rayan4444/EasyCheck/EasyCheck_rev2/Easycheck_rev2_motherboard.brd

## EAGLE design EasyCheck_rev2/Easycheck_rev2_motherboard.brd (2019-07-09)

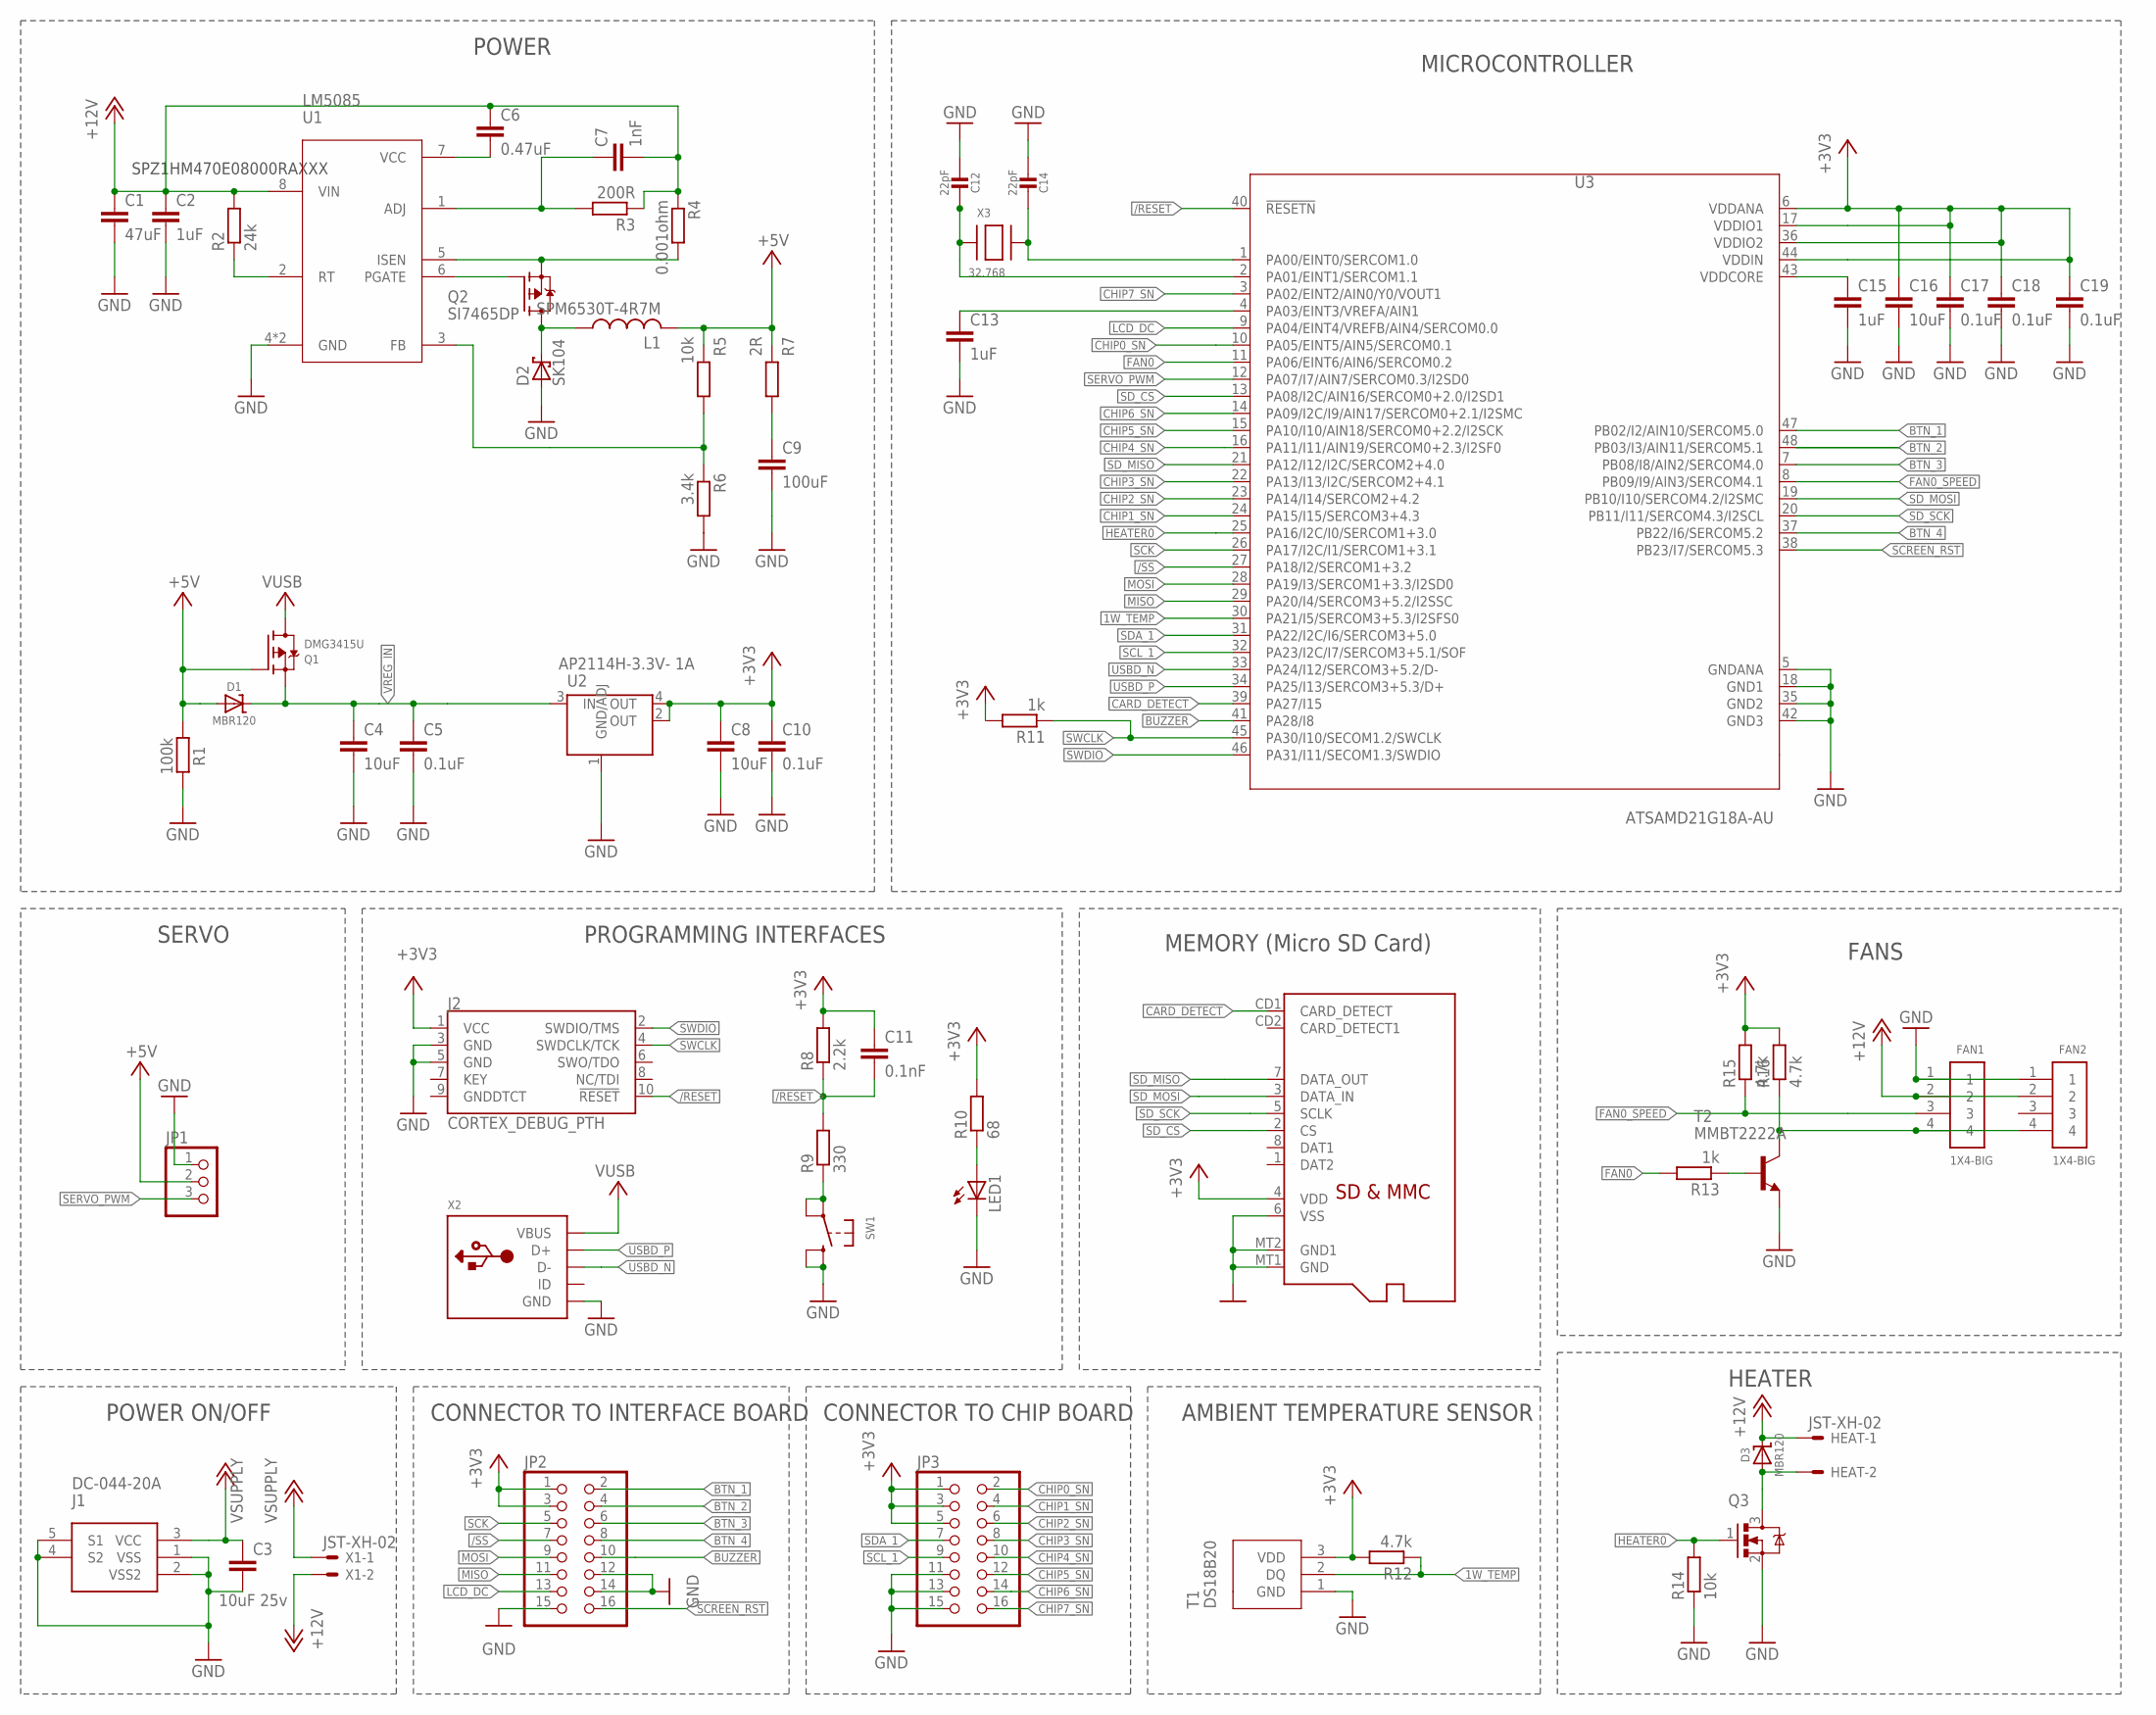
[picture p1: schematic Easycheck_rev2_motherboard.sch]

Parts:
C1: 47uF; C1206
C2: 1uF; C1206
C3: 10uF 25v; C1206
C4, C8, C16: 10uF; C0603
C5, C10, C17, C18, C19: 0.1uF; C0603
C6: 0.47uF; C1206
C7: 1nF; C0603
C9: 100uF; C0805
C11: 0.1nF; C0603
C12, C14: 22pF; 0603-NO@1
C13, C15: 1uF; C0603
D1, D3: MBR120; MICROBUILDER_SOD-123
D2: SK104
FAN1, FAN2: 1X4-BIG; 1X04-BIG
HEAT: JST-XH-02; JST-XH-02-PACKAGE-LONG-PAD
J1: DC-044-20A
J2: CORTEX_DEBUG_PTH; 2X5-PTH-1.27MM
JP1: PINHD-1X3; 1X03
JP2, JP3: PINHD-2X8; 2X08
L1: SPM6530T-4R7M
LED1: LEDCHIPLED_0603; CHIPLED_0603
Q1: DMG3415U; SOT23-R
Q2: SI7465DP; SI7465
Q3: DMN6140L; SOT91P240X110-3N
R1: 100k; R0603
R2: 24k; R0603
R3: 200R; R0603
R4: 0.001ohm; R1206
R5, R14: 10k; R0603
R6: 3.4k; R0603
R7: 2R; R0805
R8: 2.2k; R0603
R9: 330; R0603
R10: 68; R0603
R11, R13: 1k; R0603
R12, R15, R16: 4.7k; R0603
SD1: MICROSD
SW1: MICROBUILDER_SWITCH_TACT_SMT_EVQQ2_SMALL; MICROBUILDER_EVQ-Q2_SMALLER
T1: DS18B20; TO92
T2: MMBT2222A; SOT23-BEC
U1: LM5085
U2: AP2114H-3.3V- 1A; GEN_COMP_SOT223
U3: ATSAMD21G18A-AU; QFP50P900X900X120-48N
X1: JST-XH-02; JST-XH-02-PACKAGE-LONG-PAD
X2: MICROBUILDER_USB_MICRO_20329_V2; MICROBUILDER_4UCONN_20329_V2
X3: 32.768; XTAL3215

Connections:
1W_TEMP: R12.1, T1.2 (DQ), U3.30 (PA21/I5/SERCOM3+5.3/I2SFS0)
+3V3: C8.1, C10.1, C11.1, C16.1, C17.1, C18.1, C19.1, J2.1 (VCC), JP2.1, JP2.3, JP3.1, JP3.3, JP3.5, R8.2, R10.2, R11.2, R12.2, R15.2, R16.2, SD1.4 (VDD), T1.3 (VDD), U2.2 (OUT), U2.4 (OUT), U3.6 (VDDANA), U3.17 (VDDIO1), U3.36 (VDDIO2), U3.44 (VDDIN)
+5V: D1.A, JP1.2, L1.2, Q1.1 (G), R1.1, R5.1, R7.1
+12V: C1.1, C2.1, C6.1, C7.2, D3.C, FAN1.2, FAN2.2, HEAT.1, R2.2, R3.1, R4.1, U1.8 (VIN), X1.2
/RESET: C11.2, J2.10 (!RESET), R8.1, R9.2, U3.40 (!RESETN)
/SS: JP2.7, U3.27 (PA18/I2/SERCOM1+3.2)
BTN_1: JP2.2, U3.47 (PB02/I2/AIN10/SERCOM5.0)
BTN_2: JP2.4, U3.48 (PB03/I3/AIN11/SERCOM5.1)
BTN_3: JP2.6, U3.7 (PB08/I8/AIN2/SERCOM4.0)
BTN_4: JP2.8, U3.37 (PB22/I6/SERCOM5.2)
BUZZER: JP2.10, U3.41 (PA28/I8)
CARD_DETECT: SD1.CD1 (CARD_DETECT), U3.39 (PA27/I15)
CHIP0_SN: JP3.2, U3.10 (PA05/EINT5/AIN5/SERCOM0.1)
CHIP1_SN: JP3.4, U3.24 (PA15/I15/SERCOM3+4.3)
CHIP2_SN: JP3.6, U3.23 (PA14/I14/SERCOM2+4.2)
CHIP3_SN: JP3.8, U3.22 (PA13/I13/I2C/SERCOM2+4.1)
CHIP4_SN: JP3.10, U3.16 (PA11/I11/AIN19/SERCOM0+2.3/I2SF0)
CHIP5_SN: JP3.12, U3.15 (PA10/I10/AIN18/SERCOM0+2.2/I2SCK)
CHIP6_SN: JP3.14, U3.14 (PA09/I2C/I9/AIN17/SERCOM0+2.1/I2SMC)
CHIP7_SN: JP3.16, U3.3 (PA02/EINT2/AIN0/Y0/VOUT1)
FAN0: R13.2, U3.11 (PA06/EINT6/AIN6/SERCOM0.2)
FAN0_SPEED: FAN1.3, R15.1, U3.8 (PB09/I9/AIN3/SERCOM4.1)
GND: C1.2, C2.2, C3.2, C4.2, C5.2, C8.2, C9.2, C10.2, C12.2, C13.2, C14.2, C15.2, C16.2, C17.2, C18.2, C19.2, D2.1 (A), FAN1.1, FAN2.1, J1.1 (VSS), J1.2 (VSS2), J1.4 (S2), J1.5 (S1), J2.3 (GND), J2.5 (GND), JP1.1, JP2.12, JP2.14, JP2.15, JP3.11, JP3.13, JP3.15, LED1.C, Q3.2, R1.2, R6.2, R14.1, SD1.6 (VSS), SD1.MT1 (GND), SD1.MT2 (GND1), SW1.B (S), SW1.B' (S1), T1.1 (GND), T2.E, U1.4 (GND), U1.9 (GND), U2.1 (GND/ADJ), U3.5 (GNDANA), U3.18 (GND1), U3.35 (GND2), U3.42 (GND3), X2.BASE@1 (GND), X2.BASE@2 (GND), X2.GND, X2.SPRT@1 (GND), X2.SPRT@2 (GND), X2.SPRT@3 (GND), X2.SPRT@4 (GND)
HEATER0: Q3.1, R14.2, U3.25 (PA16/I2C/I0/SERCOM1+3.0)
LCD_DC: JP2.13, U3.9 (PA04/EINT4/VREFB/AIN4/SERCOM0.0)
MISO: JP2.11, U3.29 (PA20/I4/SERCOM3+5.2/I2SSC)
MOSI: JP2.9, U3.28 (PA19/I3/SERCOM1+3.3/I2SD0)
unnamed: C9.1, R7.2
unnamed: FAN1.4, FAN2.4, R16.1, T2.C
unnamed: R13.1, T2.B
unnamed: D3.A, HEAT.2, Q3.3
unnamed: R9.1, SW1.A, SW1.A' (P1)
unnamed: C12.1, U3.2 (PA01/EINT1/SERCOM1.1), X3.P$1
unnamed: C14.1, U3.1 (PA00/EINT0/SERCOM1.0), X3.P$2
unnamed: C13.1, U3.4 (PA03/EINT3/VREFA/AIN1)
unnamed: C15.1, U3.43 (VDDCORE)
unnamed: LED1.A, R10.1
unnamed: R2.1, U1.2 (RT)
unnamed: Q2.1 (S), Q2.2 (S), Q2.3 (S), R4.2, U1.5 (ISEN)
unnamed: C7.1, R3.2, U1.1 (ADJ)
unnamed: R5.2, R6.1, U1.3 (FB)
unnamed: C6.2, U1.7 (VCC)
unnamed: D2.2 (C), L1.1, Q2.5 (D), Q2.6 (D), Q2.7 (D), Q2.8 (D), Q2.9 (D)
unnamed: Q2.4 (G), U1.6 (PGATE)
SCK: JP2.5, U3.26 (PA17/I2C/I1/SERCOM1+3.1)
SCL_1: JP3.9, U3.32 (PA23/I2C/I7/SERCOM3+5.1/SOF)
SCREEN_RST: JP2.16, U3.38 (PB23/I7/SERCOM5.3)
SDA_1: JP3.7, U3.31 (PA22/I2C/I6/SERCOM3+5.0)
SD_CS: SD1.2 (CS), U3.13 (PA08/I2C/AIN16/SERCOM0+2.0/I2SD1)
SD_MISO: SD1.7 (DATA_OUT), U3.21 (PA12/I12/I2C/SERCOM2+4.0)
SD_MOSI: SD1.3 (DATA_IN), U3.19 (PB10/I10/SERCOM4.2/I2SMC)
SD_SCK: SD1.5 (SCLK), U3.20 (PB11/I11/SERCOM4.3/I2SCL)
SERVO_PWM: JP1.3, U3.12 (PA07/I7/AIN7/SERCOM0.3/I2SD0)
SWCLK: J2.4 (SWDCLK/TCK), R11.1, U3.45 (PA30/I10/SECOM1.2/SWCLK)
SWDIO: J2.2 (SWDIO/TMS), U3.46 (PA31/I11/SECOM1.3/SWDIO)
USBD_N: U3.33 (PA24/I12/SERCOM3+5.2/D-), X2.D-
USBD_P: U3.34 (PA25/I13/SERCOM3+5.3/D+), X2.D+
VREG_IN: C4.1, C5.1, D1.C, Q1.2 (S), U2.3 (IN)
VSUPPLY: C3.1, J1.3 (VCC), X1.1
VUSB: Q1.3 (D), X2.VBUS

Notes on the sheet:
POWER
SPZ1HM470E08000RAXXX
MICROCONTROLLER
MEMORY (Micro SD Card)
PROGRAMMING INTERFACES
AMBIENT TEMPERATURE SENSOR
FANS
HEATER
POWER ON/OFF
CONNECTOR TO INTERFACE BOARD
CONNECTOR TO CHIP BOARD
SERVO

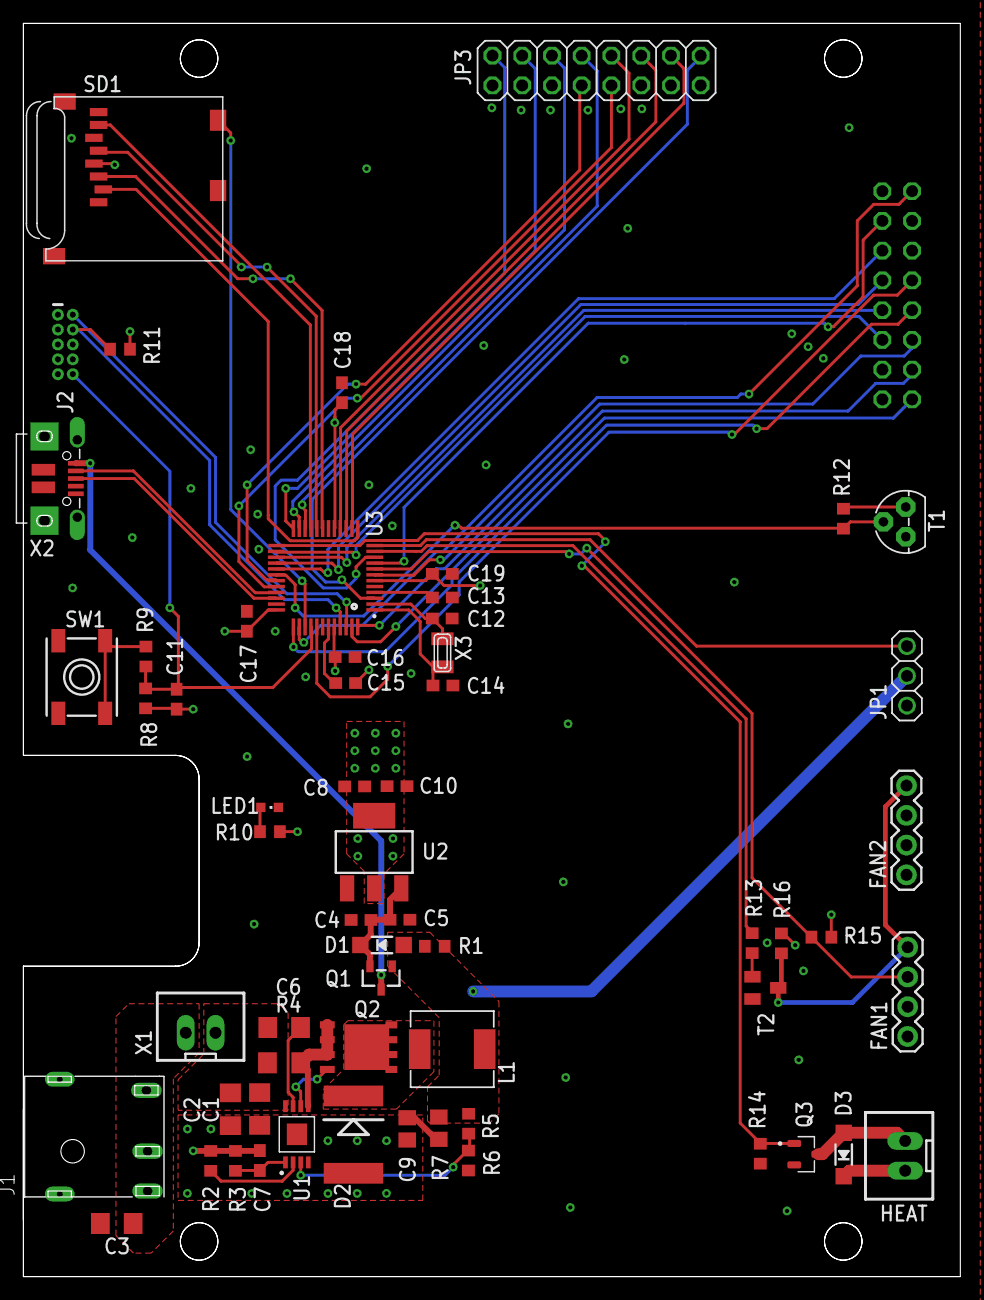
[picture p2: board Easycheck_rev2_motherboard.brd from above]

Board: 4 copper layers, 80.0 x 107.0 mm, 61 parts (1 on the bottom side), 60 nets.
