rayan4444/EasyCheck/EasyCheck_rev2/EasyCheck_rev2_interface.brd

## EAGLE design EasyCheck_rev2/EasyCheck_rev2_interface.brd (2019-07-09)

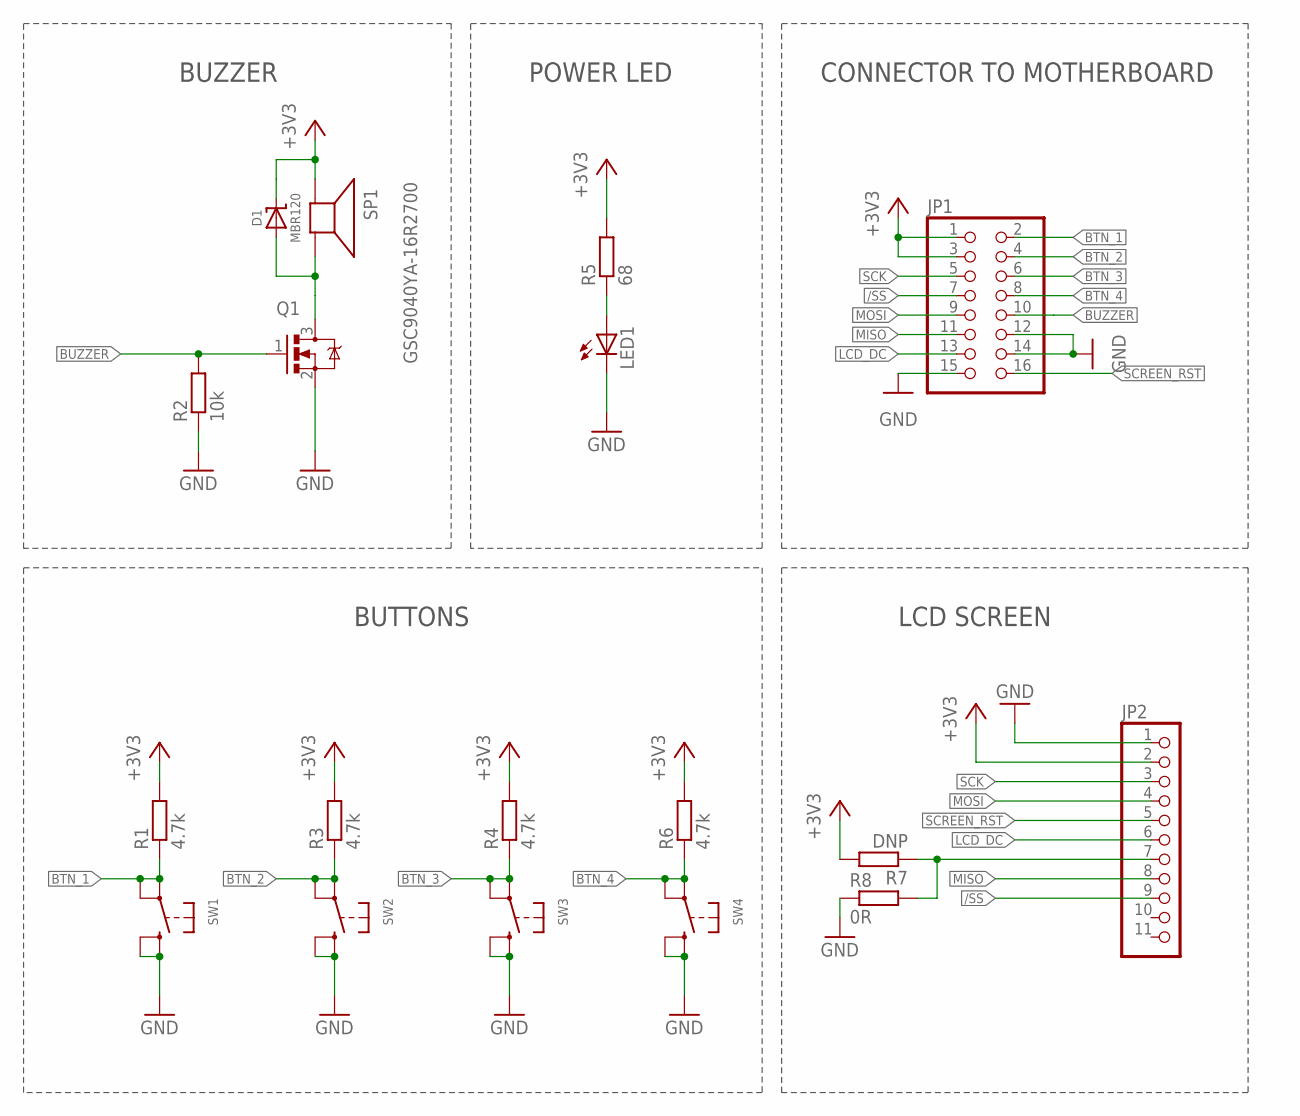
[picture p3: schematic EasyCheck_rev2_interface.sch]

Parts:
D1: MBR120; MICROBUILDER_SOD-123
JP1: PINHD-2X8; 2X08
JP2: PINHD-1X11; 1X11
LED1: LEDCHIPLED_0603; CHIPLED_0603
Q1: DMN6140L; SOT91P240X110-3N
R1, R3, R4, R6: 4.7k; R0603
R2: 10k; R0603
R5: 68; R0603
R7: DNP; R0603
R8: 0R; R0603
SP1: GSC9040YA-16R2700
SW1, SW2, SW3, SW4: MICROBUILDER_SWITCH_TACT_SMT_EVQQ2_SMALL; MICROBUILDER_EVQ-Q2_SMALLER

Connections:
+3V3: D1.C, JP1.1, JP1.3, JP2.2, R1.2, R3.2, R4.2, R5.2, R6.2, R7.2, SP1.P$3 (+)
/SS: JP1.7, JP2.9
BTN_1: JP1.2, R1.1, SW1.A, SW1.A' (P1)
BTN_2: JP1.4, R3.1, SW2.A, SW2.A' (P1)
BTN_3: JP1.6, R4.1, SW3.A, SW3.A' (P1)
BTN_4: JP1.8, R6.1, SW4.A, SW4.A' (P1)
BUZZER: JP1.10, Q1.1, R2.2
GND: JP1.12, JP1.14, JP1.15, JP2.1, LED1.C, Q1.2, R2.1, R8.1, SW1.B (S), SW1.B' (S1), SW2.B (S), SW2.B' (S1), SW3.B (S), SW3.B' (S1), SW4.B (S), SW4.B' (S1)
LCD_DC: JP1.13, JP2.6
MISO: JP1.11, JP2.8
MOSI: JP1.9, JP2.4
unnamed: JP2.7, R7.1, R8.2
unnamed: D1.A, Q1.3, SP1.P$2 (-)
unnamed: LED1.A, R5.1
SCK: JP1.5, JP2.3
SCREEN_RST: JP1.16, JP2.5

Notes on the sheet:
BUZZER
CONNECTOR TO MOTHERBOARD
BUTTONS
LCD SCREEN
POWER LED

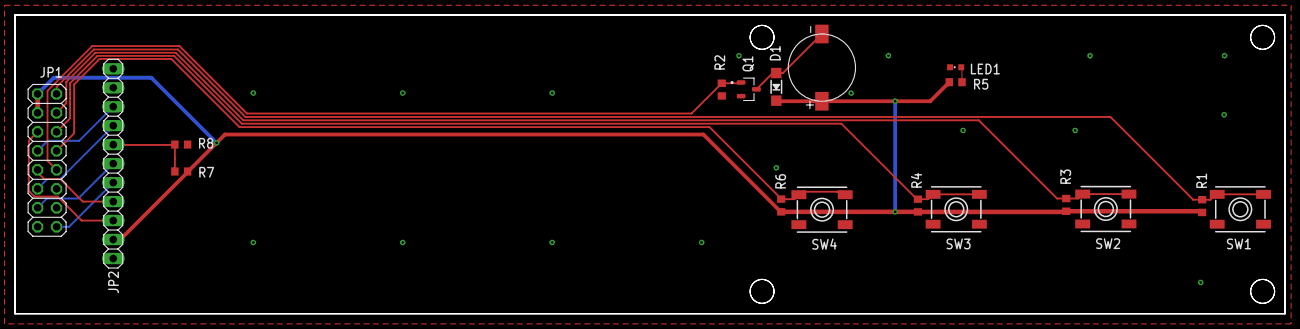
[picture p4: board EasyCheck_rev2_interface.brd from above]

Board: 2 copper layers, 170.0 x 40.0 mm, 18 parts (0 on the bottom side), 16 nets.
