rayan4444/EasyCheck/EasyCheck_rev2/Easycheck_rev2_chip.brd

## EAGLE design EasyCheck_rev2/Easycheck_rev2_chip.brd (2019-06-18)

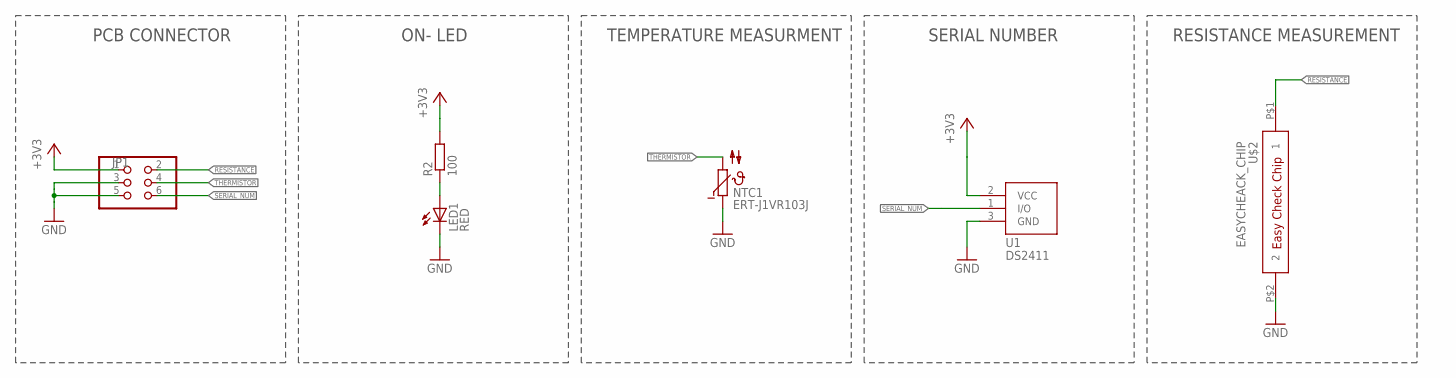
[picture p5: schematic Easycheck_rev2_chip.sch]

Parts:
JP1: PINHD-2X3; 2X03
LED1: RED; CHIPLED_0603
NTC1: ERT-J1VR103J; C0603K
R2: 100; R0402
U1: DS2411; SOT23
U$2: EASYCHEACK_CHIP; EASYCHECK_CHIP

Connections:
+3V3: JP1.1, R2.2, U1.2 (VCC)
GND: JP1.3, JP1.5, LED1.C, NTC1.1, U1.3 (GND), U$2.P$2 (2)
unnamed: LED1.A, R2.1
RESISTANCE: JP1.2, U$2.P$1 (1)
SERIAL_NUM: JP1.6, U1.1 (I/O)
THERMISTOR: JP1.4, NTC1.2

Notes on the sheet:
TEMPERATURE MEASURMENT
RESISTANCE MEASUREMENT
SERIAL NUMBER
PCB CONNECTOR
ON- LED

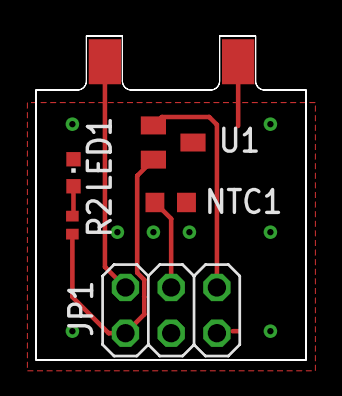
[picture p6: board Easycheck_rev2_chip.brd from above]

Board: 2 copper layers, 15.0 x 18.0 mm, 6 parts (0 on the bottom side), 6 nets.
