rayan4444/EasyCheck/EasyCheck_rev2/Easy_Check_rev2_chip_tray.brd

## EAGLE design EasyCheck_rev2/Easy_Check_rev2_chip_tray.brd (2019-06-18)

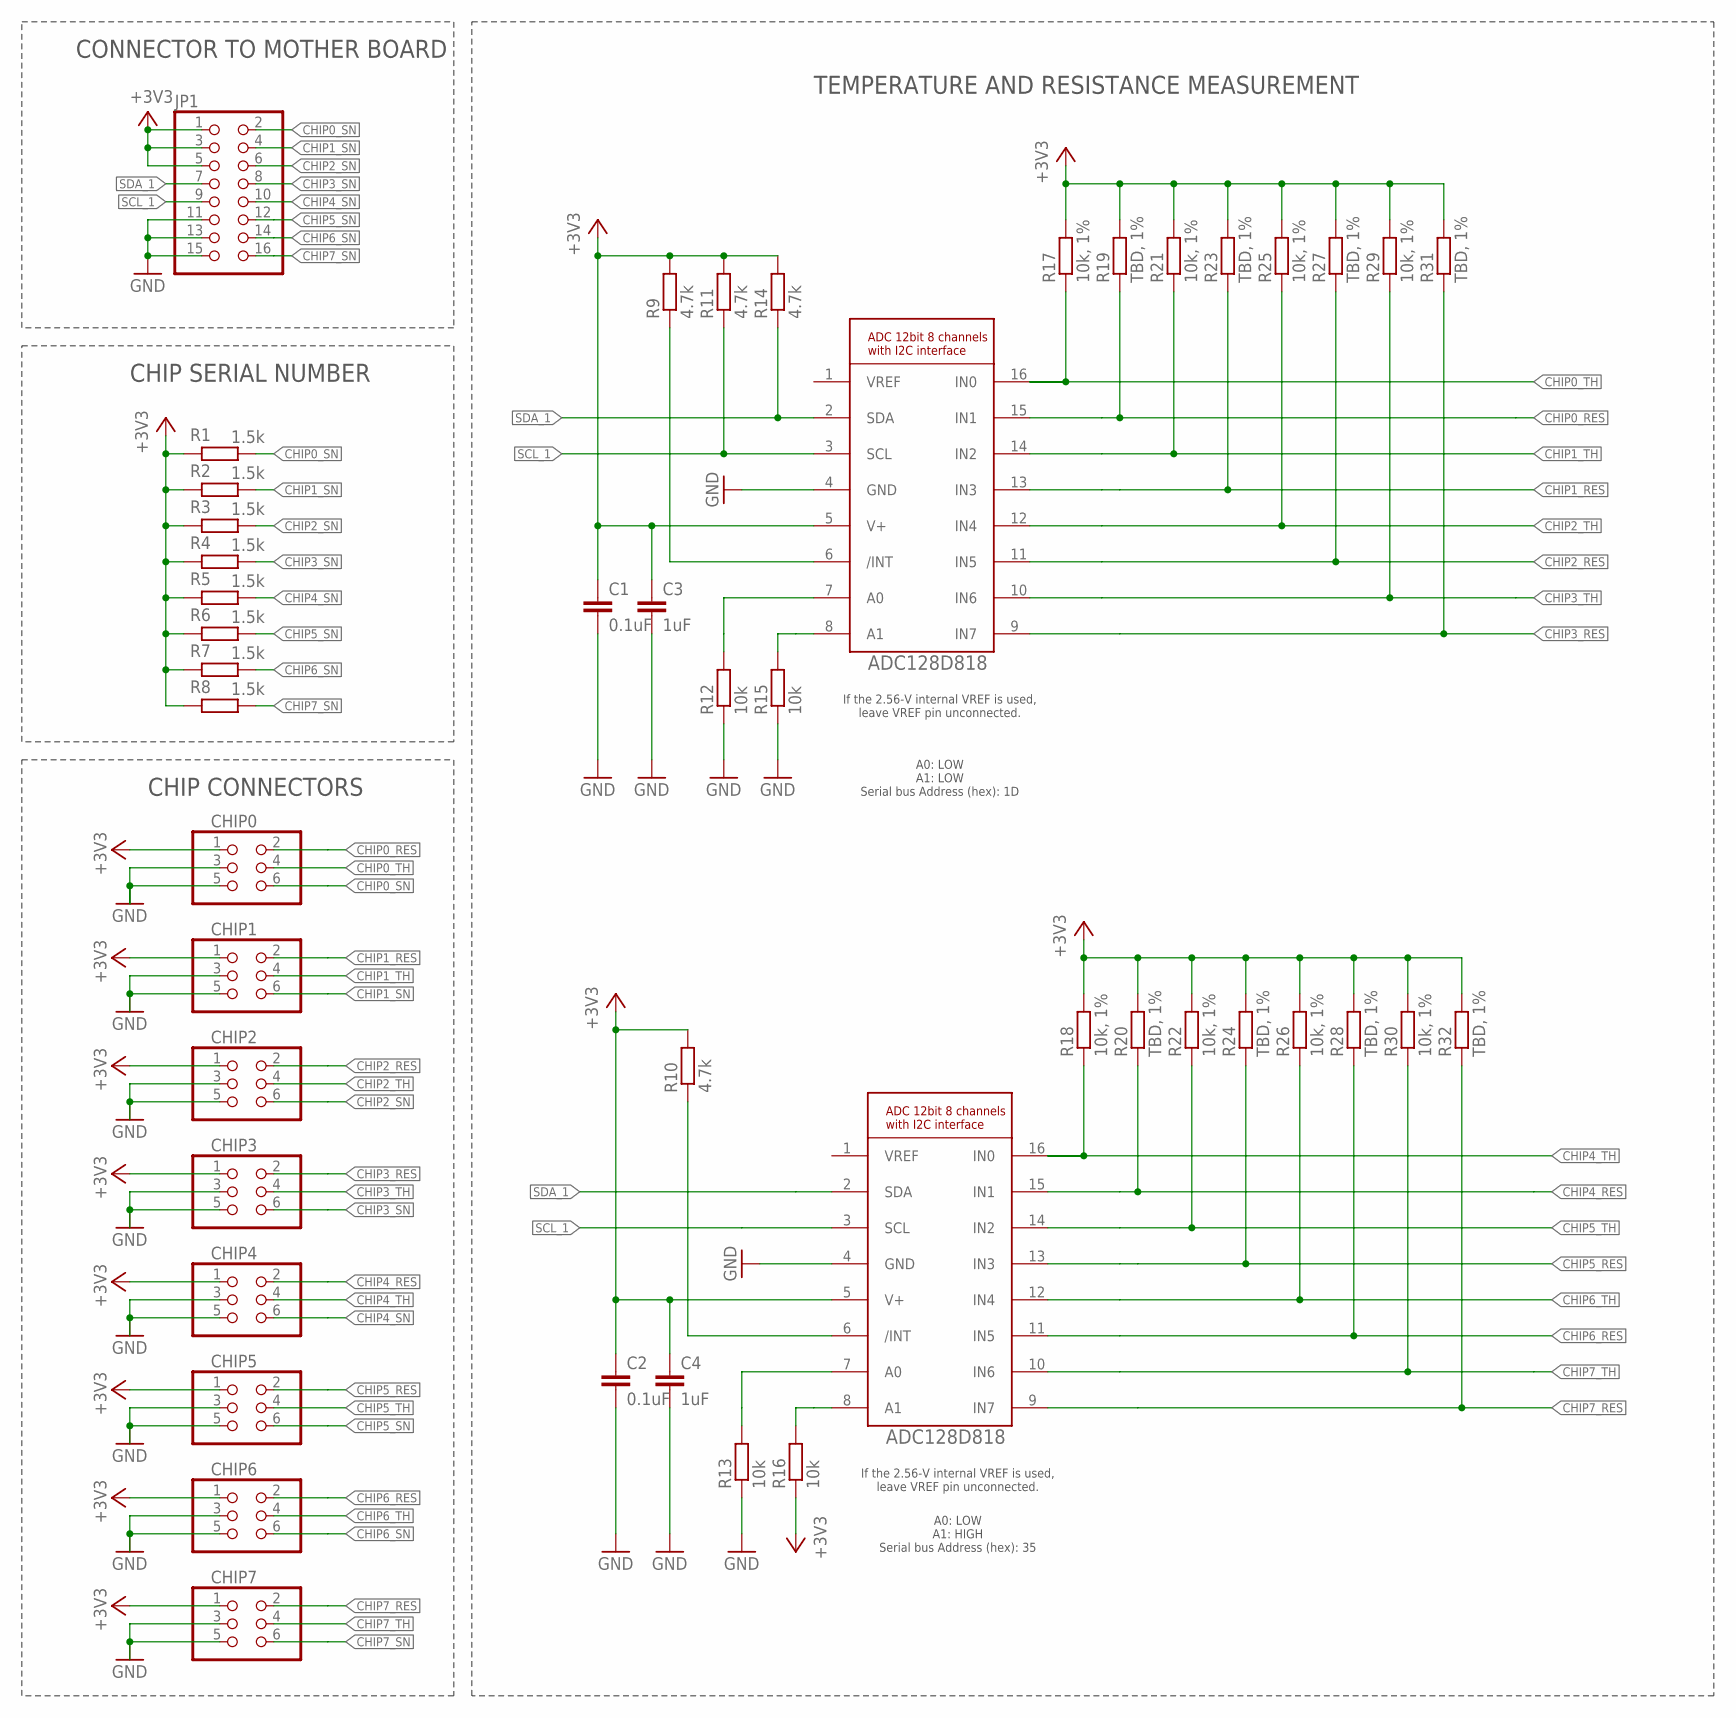
[picture p7: schematic Easy_Check_rev2_chip_tray.sch]

Parts:
C1, C2: 0.1uF; C0603
C3, C4: 1uF; C0603
CHIP0, CHIP1, CHIP2, CHIP3, CHIP4, CHIP5, CHIP6, CHIP7: PINHD-2X3; 2X03
JP1: PINHD-2X8; 2X08
R1, R2, R3, R4, R5, R6, R7, R8: 1.5k; R0603
R9, R10, R11, R14: 4.7k; R0603
R12, R13, R15, R16: 10k; R0603
R17, R18, R21, R22, R25, R26, R29, R30: 10k, 1%; R0603
R19, R20, R23, R24, R27, R28, R31, R32: TBD, 1%; R0603
U1, U2: LMD128D818; ADC128D818

Connections:
+3V3: C1.1, C2.1, C3.1, C4.1, CHIP0.1, CHIP1.1, CHIP2.1, CHIP3.1, CHIP4.1, CHIP5.1, CHIP6.1, CHIP7.1, JP1.1, JP1.3, JP1.5, R1.2, R2.2, R3.2, R4.2, R5.2, R6.2, R7.2, R8.2, R9.2, R10.2, R11.2, R14.2, R16.1, R17.2, R18.2, R19.2, R20.2, R21.2, R22.2, R23.2, R24.2, R25.2, R26.2, R27.2, R28.2, R29.2, R30.2, R31.2, R32.2, U1.5 (V+), U2.5 (V+)
CHIP0_RES: CHIP0.2, R19.1, U1.15 (IN1)
CHIP0_SN: CHIP0.6, JP1.2, R1.1
CHIP0_TH: CHIP0.4, R17.1, U1.16 (IN0)
CHIP1_RES: CHIP1.2, R23.1, U1.13 (IN3)
CHIP1_SN: CHIP1.6, JP1.4, R2.1
CHIP1_TH: CHIP1.4, R21.1, U1.14 (IN2)
CHIP2_RES: CHIP2.2, R27.1, U1.11 (IN5)
CHIP2_SN: CHIP2.6, JP1.6, R3.1
CHIP2_TH: CHIP2.4, R25.1, U1.12 (IN4)
CHIP3_RES: CHIP3.2, R31.1, U1.9 (IN7)
CHIP3_SN: CHIP3.6, JP1.8, R4.1
CHIP3_TH: CHIP3.4, R29.1, U1.10 (IN6)
CHIP4_RES: CHIP4.2, R20.1, U2.15 (IN1)
CHIP4_SN: CHIP4.6, JP1.10, R5.1
CHIP4_TH: CHIP4.4, R18.1, U2.16 (IN0)
CHIP5_RES: CHIP5.2, R24.1, U2.13 (IN3)
CHIP5_SN: CHIP5.6, JP1.12, R6.1
CHIP5_TH: CHIP5.4, R22.1, U2.14 (IN2)
CHIP6_RES: CHIP6.2, R28.1, U2.11 (IN5)
CHIP6_SN: CHIP6.6, JP1.14, R7.1
CHIP6_TH: CHIP6.4, R26.1, U2.12 (IN4)
CHIP7_RES: CHIP7.2, R32.1, U2.9 (IN7)
CHIP7_SN: CHIP7.6, JP1.16, R8.1
CHIP7_TH: CHIP7.4, R30.1, U2.10 (IN6)
GND: C1.2, C2.2, C3.2, C4.2, CHIP0.3, CHIP0.5, CHIP1.3, CHIP1.5, CHIP2.3, CHIP2.5, CHIP3.3, CHIP3.5, CHIP4.3, CHIP4.5, CHIP5.3, CHIP5.5, CHIP6.3, CHIP6.5, CHIP7.3, CHIP7.5, JP1.11, JP1.13, JP1.15, R12.1, R13.1, R15.1, U1.4 (GND), U2.4 (GND)
unnamed: R9.1, U1.6 (/INT)
unnamed: R10.1, U2.6 (/INT)
unnamed: R12.2, U1.7 (A0)
unnamed: R15.2, U1.8 (A1)
unnamed: R13.2, U2.7 (A0)
unnamed: R16.2, U2.8 (A1)
SCL_1: JP1.9, R11.1, U1.3 (SCL), U2.3 (SCL)
SDA_1: JP1.7, R14.1, U1.2 (SDA), U2.2 (SDA)

Notes on the sheet:
CONNECTOR TO MOTHER BOARD
TEMPERATURE AND RESISTANCE MEASUREMENT
A0: LOW A1: LOW Serial bus Address (hex): 1D
A0: LOW A1: HIGH Serial bus Address (hex): 35
If the 2.56-V internal VREF is used, leave VREF pin unconnected.
CHIP SERIAL NUMBER
CHIP CONNECTORS

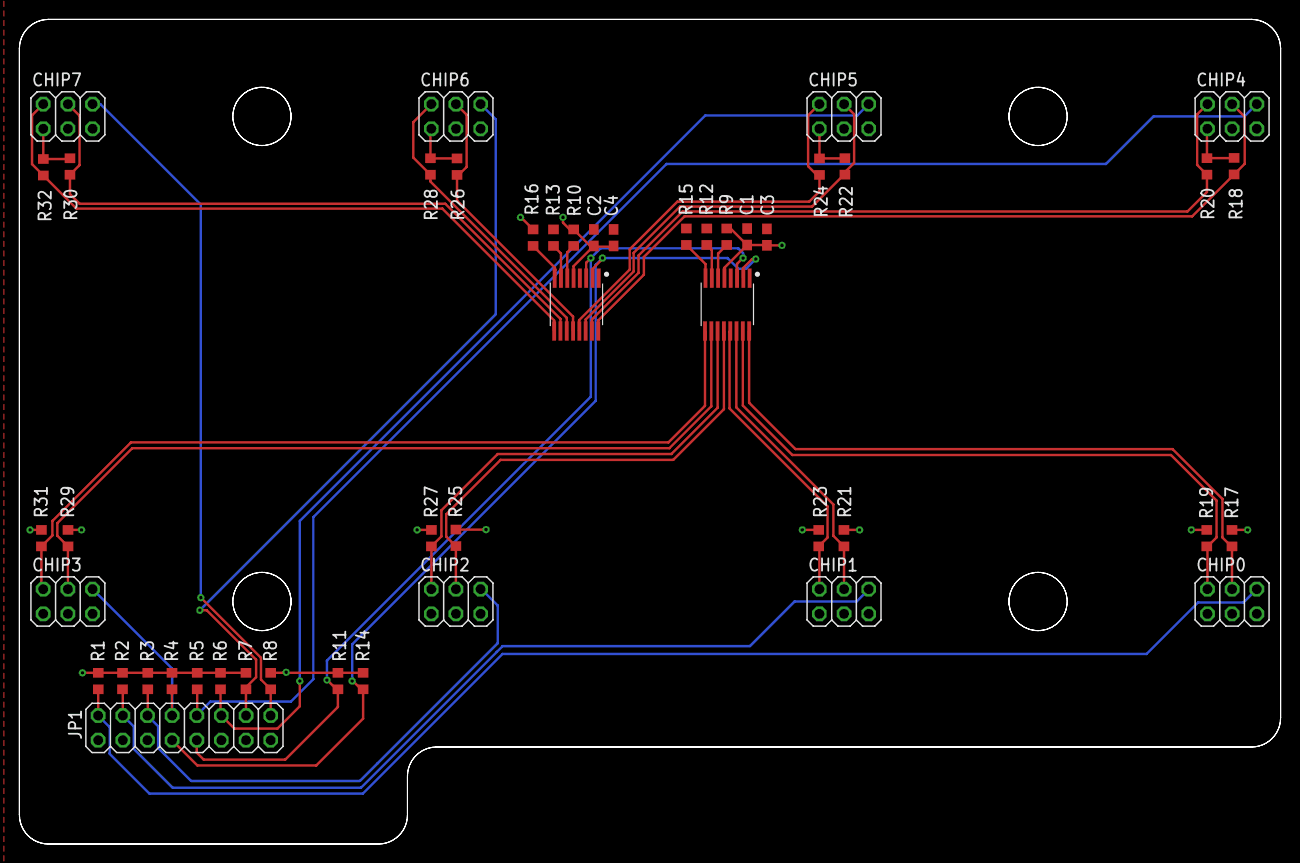
[picture p8: board Easy_Check_rev2_chip_tray.brd from above]

Board: 2 copper layers, 130.0 x 85.0 mm, 47 parts (0 on the bottom side), 34 nets.
