rayan4444/EasyCheck/EasyCheck_rev1/EasyCheck_rev1.brd

## EAGLE design EasyCheck_rev1/EasyCheck_rev1.brd (2019-05-28, an earlier design)

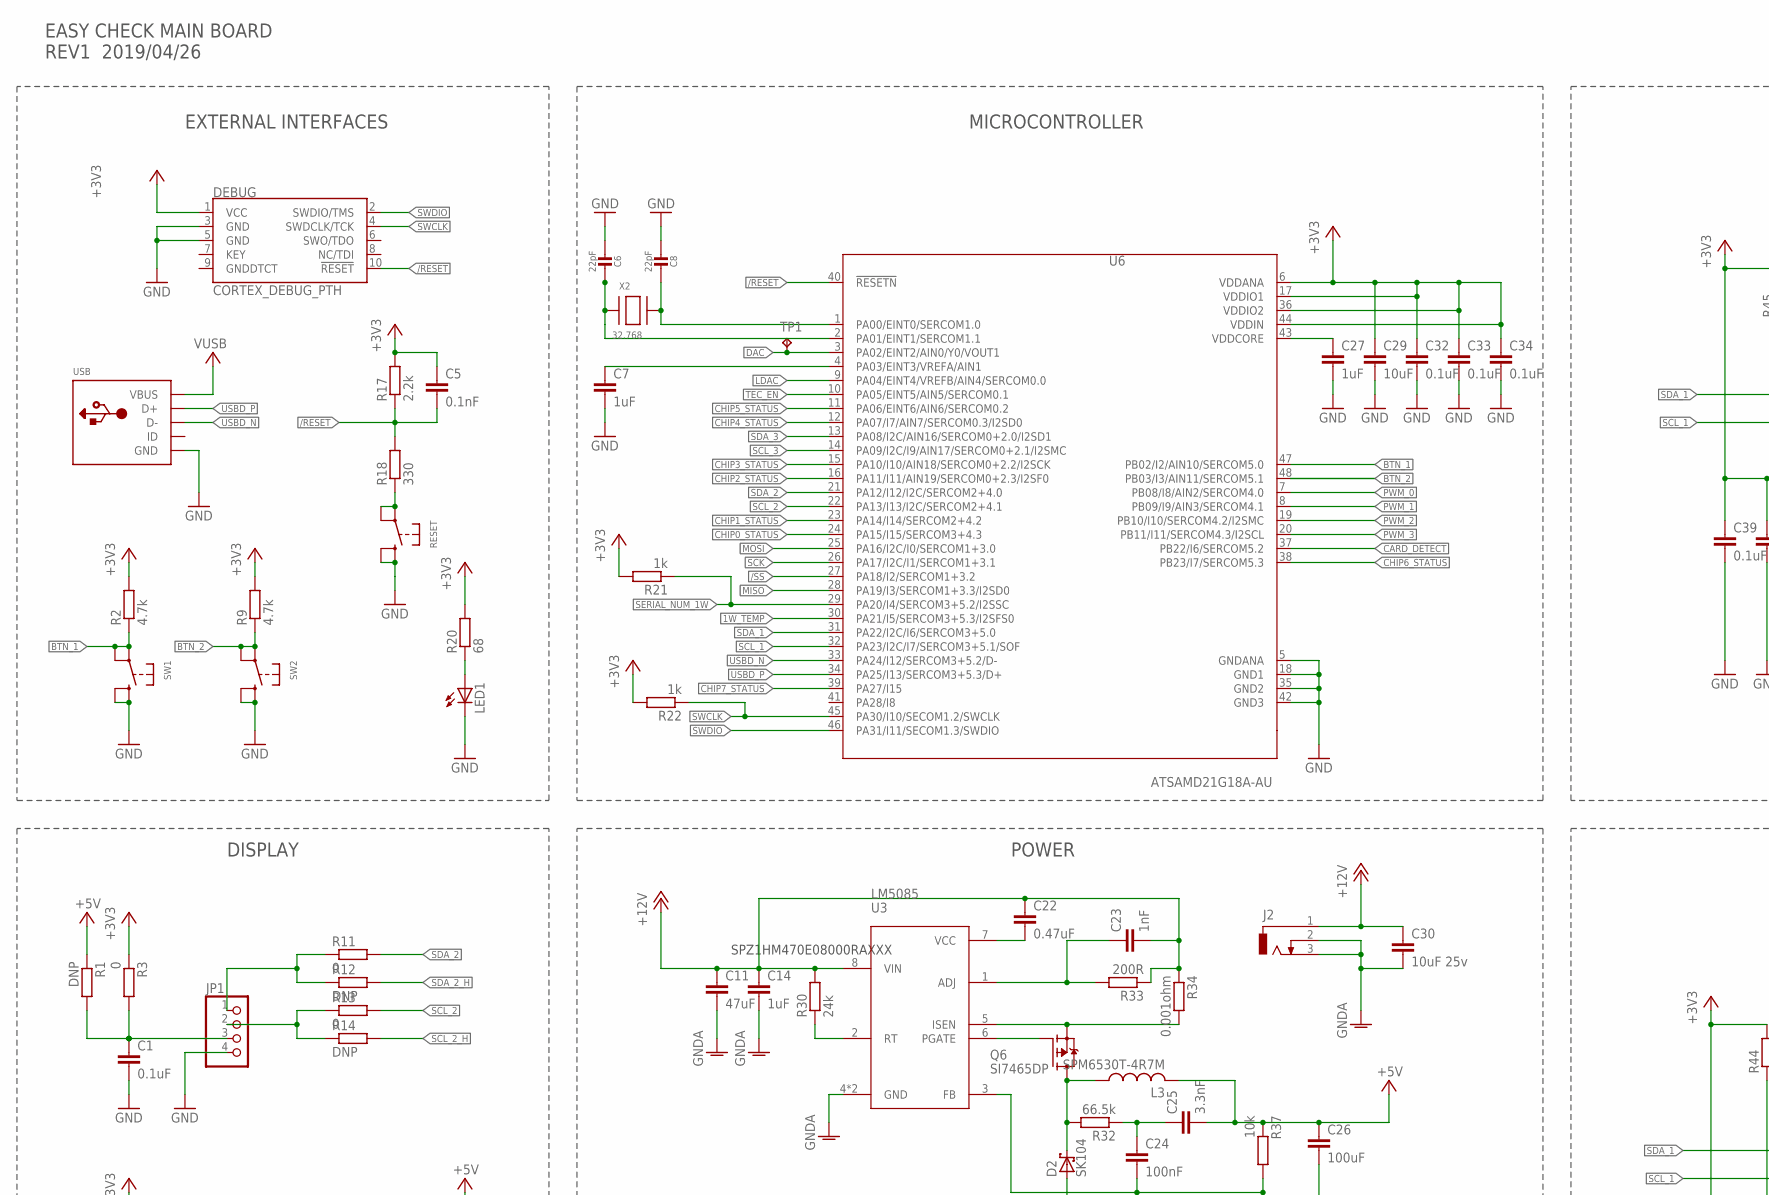
[picture p9: schematic EasyCheck_rev1.sch, part in row 1, column 1]

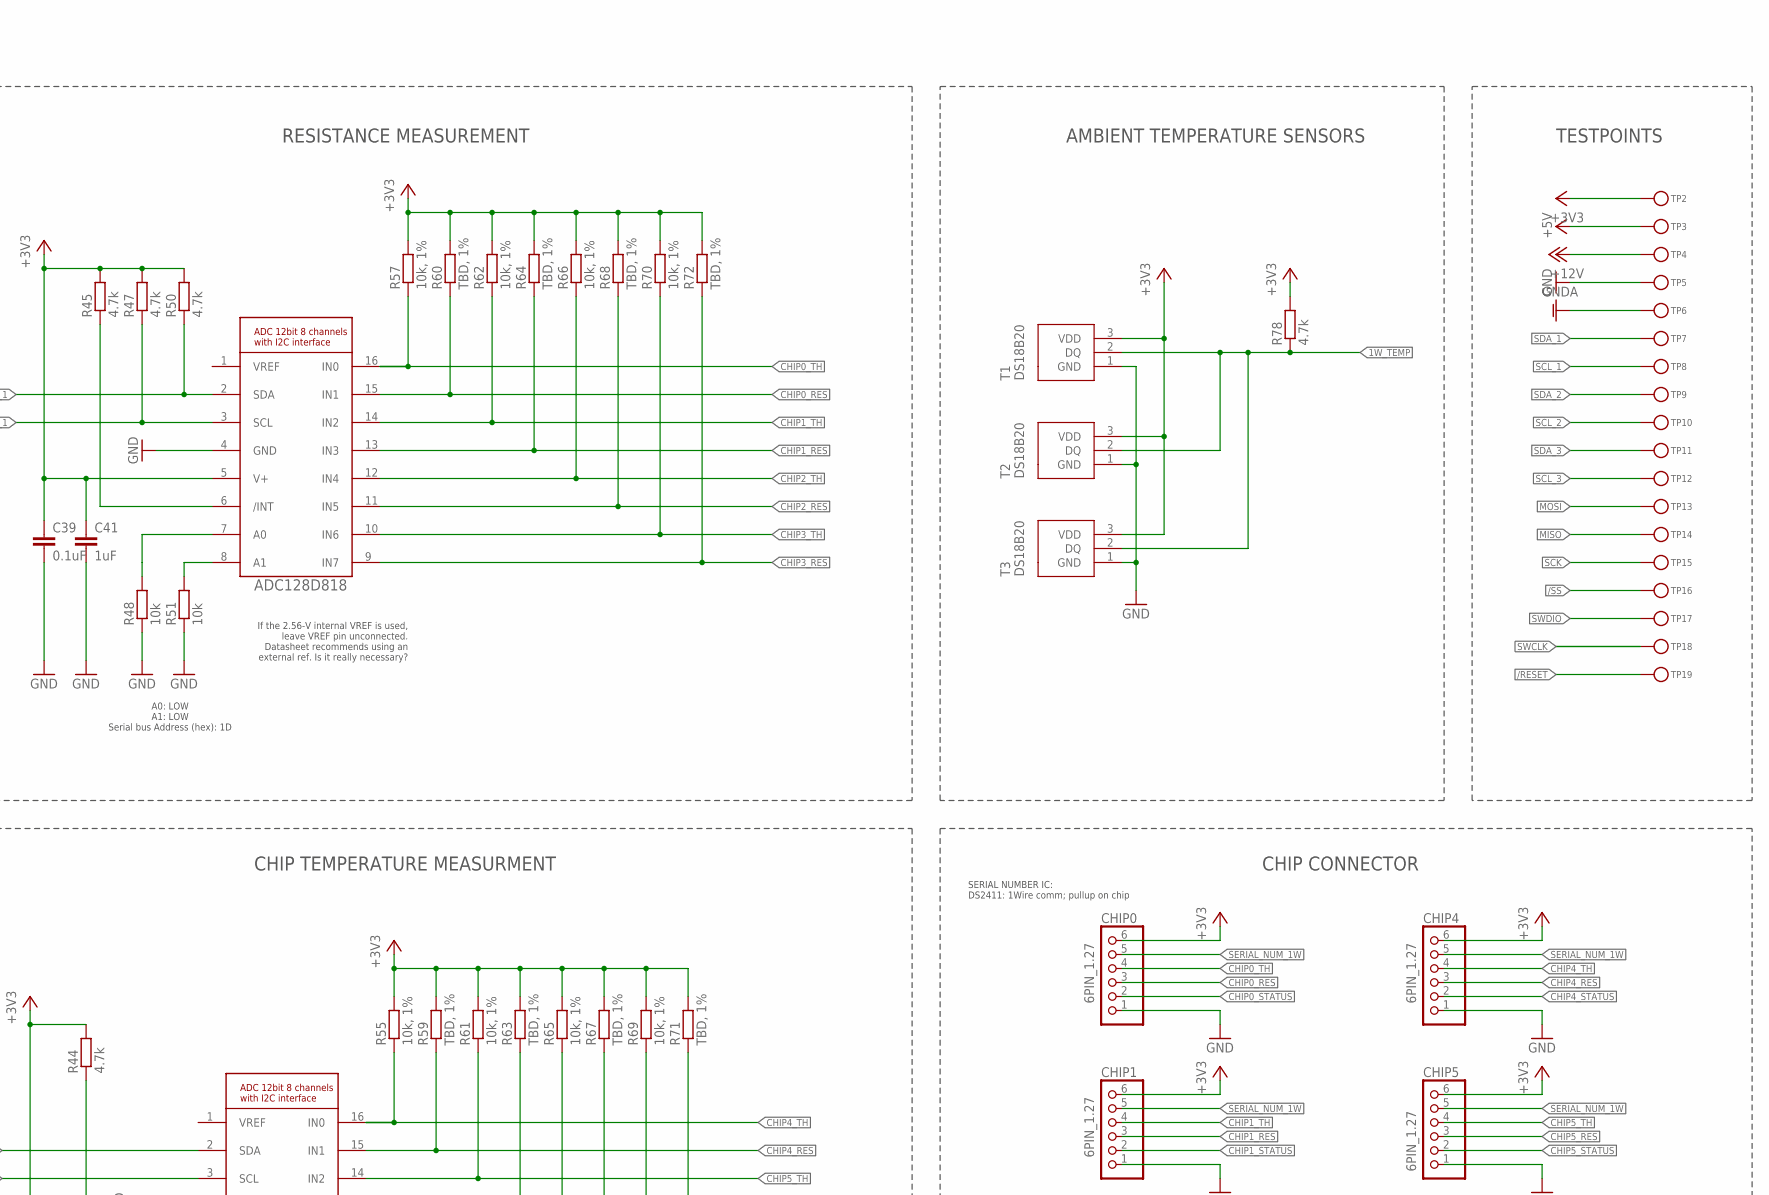
[picture p10: schematic EasyCheck_rev1.sch, part in row 1, column 2]

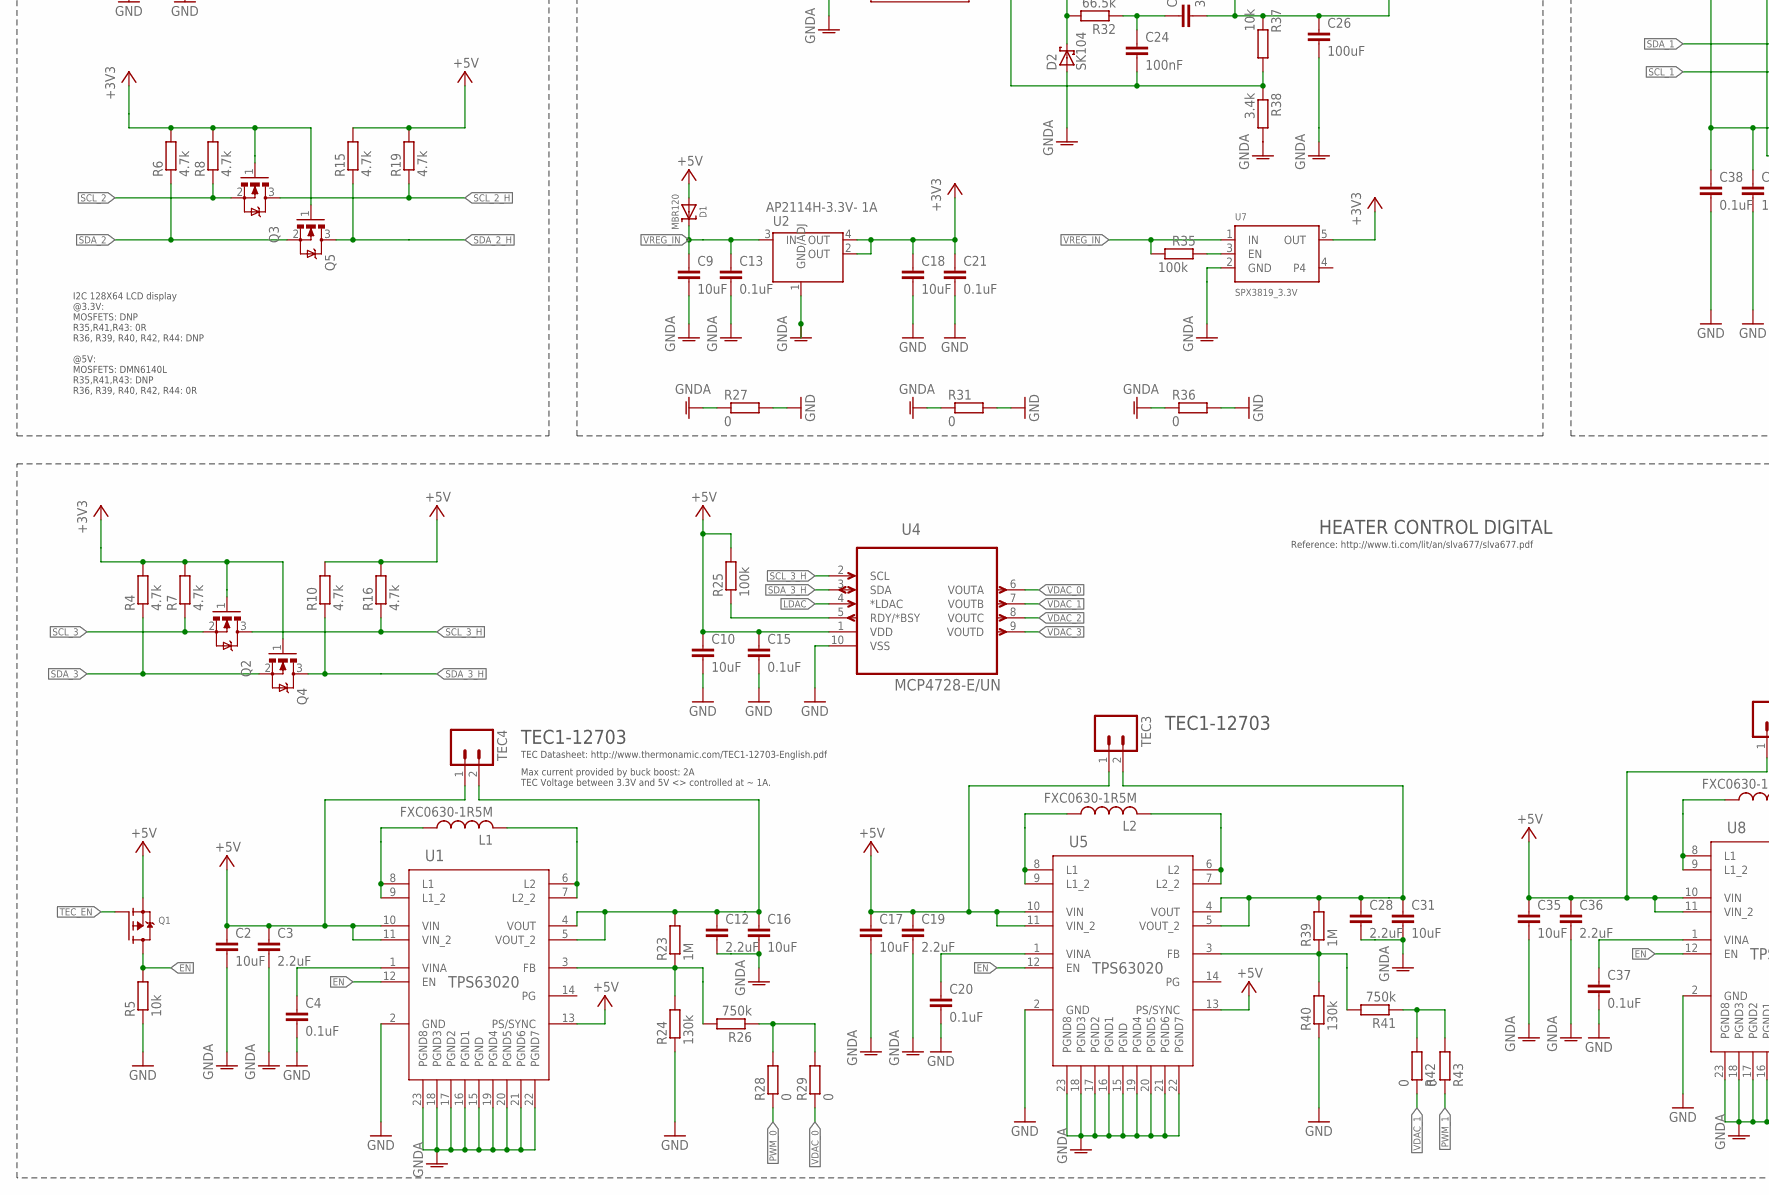
[picture p11: schematic EasyCheck_rev1.sch, part in row 2, column 1]

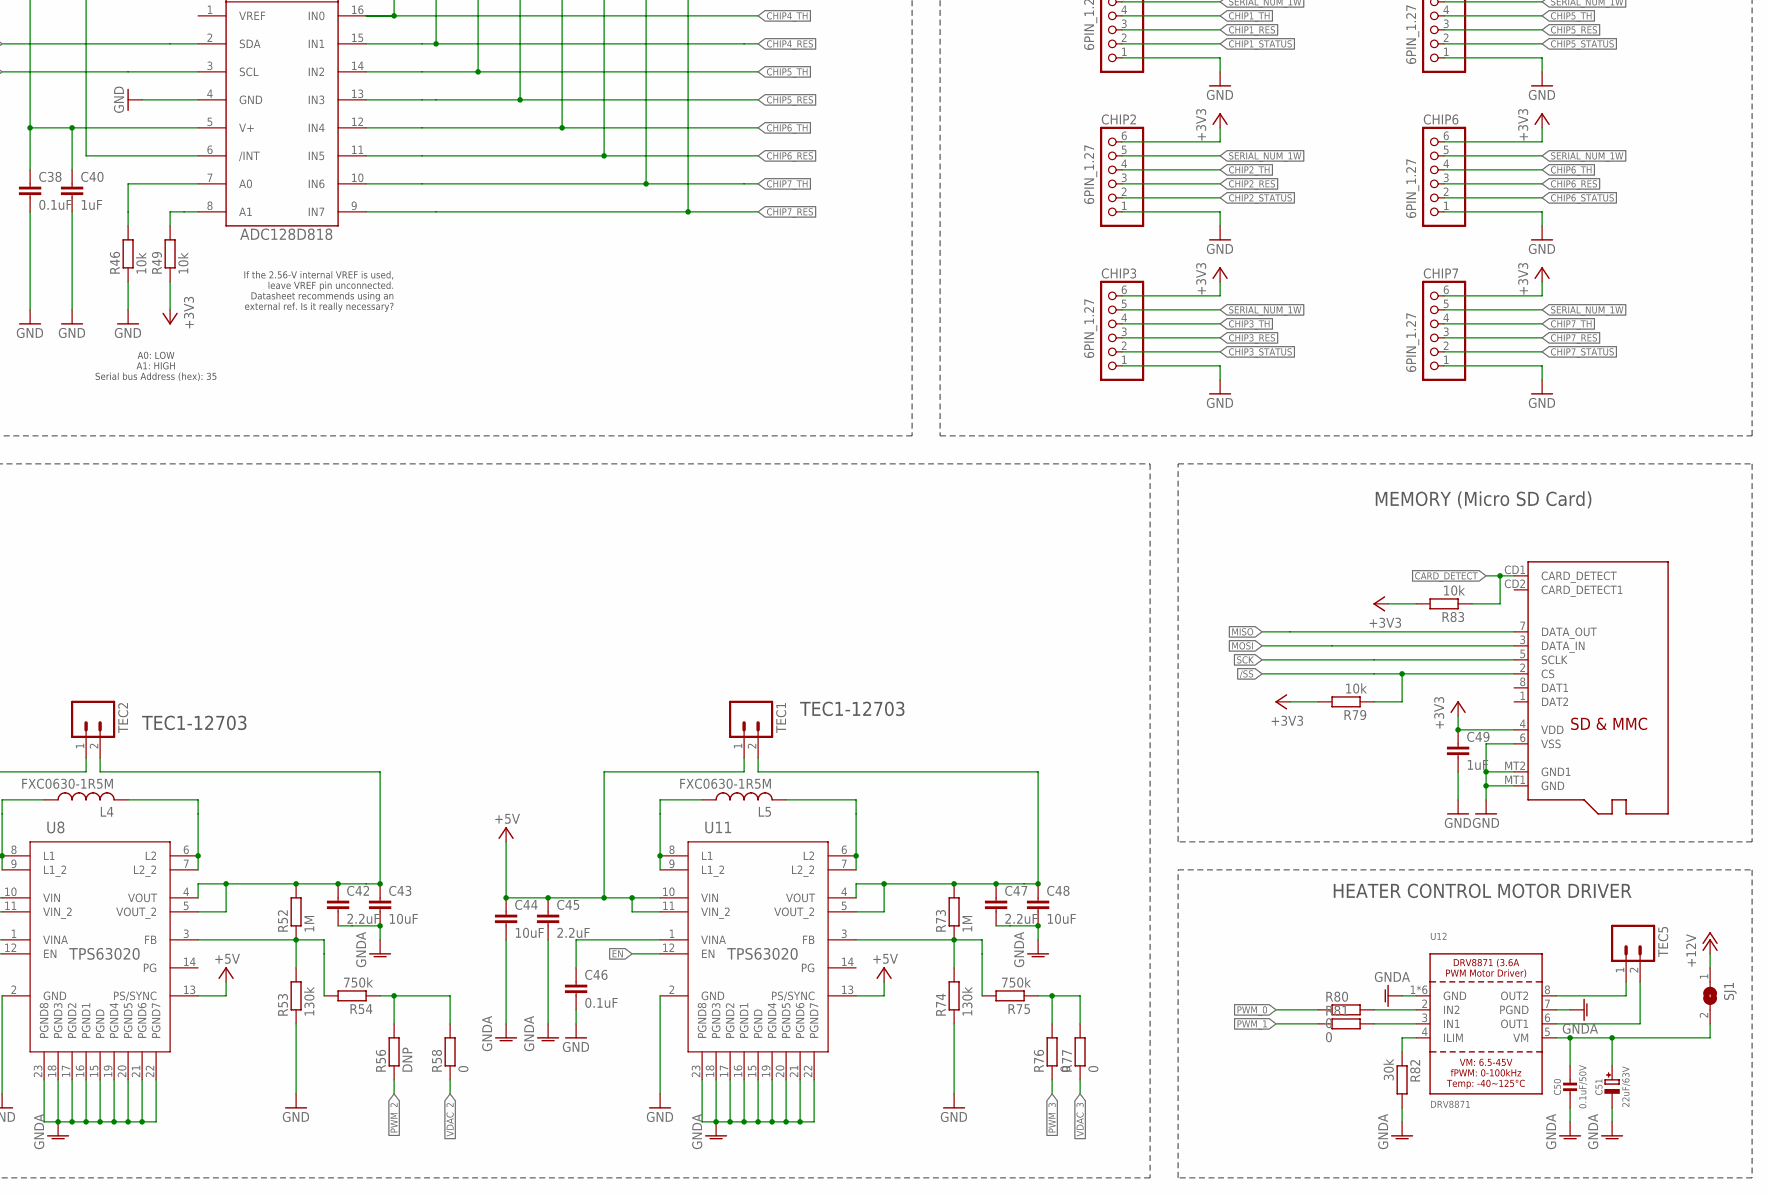
[picture p12: schematic EasyCheck_rev1.sch, part in row 2, column 2]

Parts:
C1, C4, C13, C15, C20, C21, C32, C33, C34, C37, C38, C39, C46: 0.1uF; C0603
C2, C16, C17, C31, C43, C44, C48: 10uF; C0805
C3, C12, C19, C28, C42, C45, C47: 2.2uF; C0805
C5: 0.1nF; C0603
C6, C8: 22pF; 0603-NO
C7, C27, C40, C41, C49: 1uF; C0603
C9, C10, C18, C29, C35: 10uF; C0603
C11: 47uF; C1206
C14: 1uF; C1206
C22: 0.47uF; C1206
C23: 1nF; C0603
C24: 100nF; C0603
C25: 3.3nF; C0603
C26: 100uF; C1206
C30: 10uF 25v; C1206
C36: 2.2uF; C0603
C50: 0.1uF/50V; 0805-NO
C51: 22uF/63V; PANASONIC_D
CHIP0, CHIP1, CHIP2, CHIP3, CHIP4, CHIP5, CHIP6, CHIP7: 6PIN_1.27; 6X1PIN_1.27
D1: MBR120; MICROBUILDER_SOD-123
D2: SK104
DEBUG: CORTEX_DEBUG_PTH; 2X5-PTH-1.27MM
J2: DCJ0303
JP1: PINHD-1X4; 1X04
L1, L2, L4, L5: FXC0630-1R5M; PIS2816
L3: SPM6530T-4R7M
LED1: LEDCHIPLED_0603; CHIPLED_0603
Q1: MICROBUILDER_MOSFET-P; MICROBUILDER_SOT23-R
Q2, Q3, Q4, Q5: DMN6140L; SOT91P240X110-3N
Q6: SI7465DP; SI7465
R1, R12, R14, R56: DNP; R0603
R2, R4, R6, R7, R8, R9, R10, R15, R16, R19, R44, R45, R47, R50, R78: 4.7k; R0603
R3, R11, R13, R27, R28, R29, R31, R36, R42, R43, R58, R76, R77, R80, R81: 0; R0603
R5, R37, R46, R48, R49, R51, R79, R83: 10k; R0603
R17: 2.2k; R0603
R18: 330; R0603
R20: 68; R0603
R21, R22: 1k; R0603
R23, R39, R52, R73: 1M; R0603
R24, R40, R53, R74: 130k; R0603
R25, R35: 100k; R0603
R26, R41, R54, R75: 750k; R0603
R30: 24k; R0603
R32: 66.5k; R0603
R33: 200R; R0603
R34: 0.001ohm; R1206
R38: 3.4k; R0603
R55, R57, R61, R62, R65, R66, R69, R70: 10k, 1%; R0603
R59, R60, R63, R64, R67, R68, R71, R72: TBD, 1%; R0603
R82: 30k; R0603
RESET: MICROBUILDER_SWITCH_TACT_SMT_EVQQ2_SMALL; MICROBUILDER_EVQ-Q2_SMALLER
SD1: MICROSD
SJ1: SJW
SW1, SW2: MICROBUILDER_SWITCH_TACT_SMT_EVQQ2_SMALL; MICROBUILDER_EVQ-Q2_SMALLER
T1, T2, T3: DS18B20; TO92
TEC1, TEC2, TEC3, TEC4, TEC5: SPARKFUN-CONNECTORS_M025MM; SPARKFUN-CONNECTORS_SCREWTERMINAL-5MM-2$1
TP1: TPPAD1-17; P1-17
TP2, TP3, TP4, TP5, TP6, TP7, TP8, TP9, TP10, TP11, TP12, TP13, TP14, TP15, TP16, TP17, TP18, TP19: MICROBUILDER_TESTPOINTROUND1.5MM; MICROBUILDER_TESTPOINT_ROUND_1.5MM
U1, U5, U8, U11: TPS63020; QFN14-3X4MM
U2: AP2114H-3.3V- 1A; GEN_COMP_SOT223
U3: LM5085
U4: MCP4728-E/UN; SOP50P490X110-10N
U6: ATSAMD21G18A-AU; QFP50P900X900X120-48N
U7: SPX3819_3.3V; MICROBUILDER_SOT23-5
U9, U10: LMD128D818; ADC128D818
U12: DRV8871; HSOP8
USB: MICROBUILDER_USB_MICRO_20329_V2; MICROBUILDER_4UCONN_20329_V2
X2: 32.768; XTAL3215

Connections:
1W_TEMP: R78.1, T1.2 (DQ), T2.2 (DQ), T3.2 (DQ), U6.30 (PA21/I5/SERCOM3+5.3/I2SFS0)
+3V3: C5.1, C18.1, C21.1, C29.1, C32.1, C33.1, C34.1, C38.1, C39.1, C40.1, C41.1, C49.1, CHIP0.6, CHIP1.6, CHIP2.6, CHIP3.6, CHIP4.6, CHIP5.6, CHIP6.6, CHIP7.6, DEBUG.1 (VCC), Q2.1, Q3.1, Q4.1, Q5.1, R2.2, R3.1, R4.2, R6.2, R7.2, R8.2, R9.2, R17.2, R20.2, R21.2, R22.2, R44.2, R45.2, R47.2, R49.1, R50.2, R55.2, R57.2, R59.2, R60.2, R61.2, R62.2, R63.2, R64.2, R65.2, R66.2, R67.2, R68.2, R69.2, R70.2, R71.2, R72.2, R78.2, R79.2, R83.2, SD1.4 (VDD), T1.3 (VDD), T2.3 (VDD), T3.3 (VDD), TP2.P$1, U2.2 (OUT), U2.4 (OUT), U6.6 (VDDANA), U6.17 (VDDIO1), U6.36 (VDDIO2), U6.44 (VDDIN), U7.5 (OUT), U9.5 (V+), U10.5 (V+)
+5V: C2.1, C3.1, C10.1, C15.1, C17.1, C19.1, C25.2, C26.1, C35.1, C36.1, C44.1, C45.1, D1.A, L3.2, Q1.2 (S), R1.1, R10.2, R15.2, R16.2, R19.2, R25.2, R37.1, TEC1.1, TEC2.1, TEC3.1, TEC4.1, TP3.P$1, U1.10 (VIN), U1.11 (VIN_2), U1.13 (PS/SYNC), U4.1 (VDD), U5.10 (VIN), U5.11 (VIN_2), U5.13 (PS/SYNC), U8.10 (VIN), U8.11 (VIN_2), U8.13 (PS/SYNC), U11.10 (VIN), U11.11 (VIN_2), U11.13 (PS/SYNC)
+12V: C11.1, C14.1, C22.1, C23.2, C30.1, J2.1, R30.2, R33.1, R34.1, SJ1.1, TP4.P$1, U3.8 (VIN)
/RESET: C5.2, DEBUG.10 (!RESET), R17.1, R18.2, TP19.P$1, U6.40 (!RESETN)
/SS: R79.1, SD1.2 (CS), TP16.P$1, U6.27 (PA18/I2/SERCOM1+3.2)
BTN_1: R2.1, SW1.A, SW1.A' (P1), U6.47 (PB02/I2/AIN10/SERCOM5.0)
BTN_2: R9.1, SW2.A, SW2.A' (P1), U6.48 (PB03/I3/AIN11/SERCOM5.1)
CARD_DETECT: R83.1, SD1.CD1 (CARD_DETECT), U6.37 (PB22/I6/SERCOM5.2)
CHIP0_RES: CHIP0.3, R60.1, U10.15 (IN1)
CHIP0_STATUS: CHIP0.2, U6.24 (PA15/I15/SERCOM3+4.3)
CHIP0_TH: CHIP0.4, R57.1, U10.16 (IN0)
CHIP1_RES: CHIP1.3, R64.1, U10.13 (IN3)
CHIP1_STATUS: CHIP1.2, U6.23 (PA14/I14/SERCOM2+4.2)
CHIP1_TH: CHIP1.4, R62.1, U10.14 (IN2)
CHIP2_RES: CHIP2.3, R68.1, U10.11 (IN5)
CHIP2_STATUS: CHIP2.2, U6.16 (PA11/I11/AIN19/SERCOM0+2.3/I2SF0)
CHIP2_TH: CHIP2.4, R66.1, U10.12 (IN4)
CHIP3_RES: CHIP3.3, R72.1, U10.9 (IN7)
CHIP3_STATUS: CHIP3.2, U6.15 (PA10/I10/AIN18/SERCOM0+2.2/I2SCK)
CHIP3_TH: CHIP3.4, R70.1, U10.10 (IN6)
CHIP4_RES: CHIP4.3, R59.1, U9.15 (IN1)
CHIP4_STATUS: CHIP4.2, U6.12 (PA07/I7/AIN7/SERCOM0.3/I2SD0)
CHIP4_TH: CHIP4.4, R55.1, U9.16 (IN0)
CHIP5_RES: CHIP5.3, R63.1, U9.13 (IN3)
CHIP5_STATUS: CHIP5.2, U6.11 (PA06/EINT6/AIN6/SERCOM0.2)
CHIP5_TH: CHIP5.4, R61.1, U9.14 (IN2)
CHIP6_RES: CHIP6.3, R67.1, U9.11 (IN5)
CHIP6_STATUS: CHIP6.2, U6.38 (PB23/I7/SERCOM5.3)
CHIP6_TH: CHIP6.4, R65.1, U9.12 (IN4)
CHIP7_RES: CHIP7.3, R71.1, U9.9 (IN7)
CHIP7_STATUS: CHIP7.2, U6.39 (PA27/I15)
CHIP7_TH: CHIP7.4, R69.1, U9.10 (IN6)
DAC: TP1.TP, U6.3 (PA02/EINT2/AIN0/Y0/VOUT1)
EN: Q1.3 (D), R5.2, U1.12 (EN), U5.12 (EN), U8.12 (EN), U11.12 (EN)
GND: C1.2, C4.2, C6.2, C7.2, C8.2, C10.2, C15.2, C18.2, C20.2, C21.2, C27.2, C29.2, C32.2, C33.2, C34.2, C37.2, C38.2, C39.2, C40.2, C41.2, C46.2, C49.2, CHIP0.1, CHIP1.1, CHIP2.1, CHIP3.1, CHIP4.1, CHIP5.1, CHIP6.1, CHIP7.1, DEBUG.3 (GND), DEBUG.5 (GND), JP1.4, LED1.C, R5.1, R24.1, R27.2, R31.2, R36.2, R40.1, R46.1, R48.1, R51.1, R53.1, R74.1, RESET.B (S), RESET.B' (S1), SD1.6 (VSS), SD1.MT1 (GND), SD1.MT2 (GND1), SW1.B (S), SW1.B' (S1), SW2.B (S), SW2.B' (S1), T1.1 (GND), T2.1 (GND), T3.1 (GND), TP5.P$1, U1.2 (GND), U4.10 (VSS), U5.2 (GND), U6.5 (GNDANA), U6.18 (GND1), U6.35 (GND2), U6.42 (GND3), U8.2 (GND), U9.4 (GND), U10.4 (GND), U11.2 (GND), USB.BASE@1 (GND), USB.BASE@2 (GND), USB.GND, USB.SPRT@1 (GND), USB.SPRT@2 (GND), USB.SPRT@3 (GND), USB.SPRT@4 (GND)
GNDA: C2.2, C3.2, C9.2, C11.2, C12.2, C13.2, C14.2, C16.2, C17.2, C19.2, C26.2, C28.2, C30.2, C31.2, C35.2, C36.2, C42.2, C43.2, C44.2, C45.2, C47.2, C48.2, C50.2, C51.-, D2.1 (A), J2.2, J2.3, R27.1, R31.1, R36.1, R38.2, R82.2, TP6.P$1, U1.15 (PGND), U1.16 (PGND1), U1.17 (PGND2), U1.18 (PGND3), U1.19 (PGND4), U1.20 (PGND5), U1.21 (PGND6), U1.22 (PGND7), U1.23 (PGND8), U2.1 (GND/ADJ), U3.4 (GND), U3.9 (GND), U5.15 (PGND), U5.16 (PGND1), U5.17 (PGND2), U5.18 (PGND3), U5.19 (PGND4), U5.20 (PGND5), U5.21 (PGND6), U5.22 (PGND7), U5.23 (PGND8), U7.2 (GND), U8.15 (PGND), U8.16 (PGND1), U8.17 (PGND2), U8.18 (PGND3), U8.19 (PGND4), U8.20 (PGND5), U8.21 (PGND6), U8.22 (PGND7), U8.23 (PGND8), U11.15 (PGND), U11.16 (PGND1), U11.17 (PGND2), U11.18 (PGND3), U11.19 (PGND4), U11.20 (PGND5), U11.21 (PGND6), U11.22 (PGND7), U11.23 (PGND8), U12.1 (GND), U12.7 (PGND), U12.GND, U12.P$1 (GND), U12.P$2 (GND), U12.P$3 (GND), U12.P$4 (GND)
LDAC: U4.4 (*LDAC), U6.9 (PA04/EINT4/VREFB/AIN4/SERCOM0.0)
MISO: SD1.7 (DATA_OUT), TP14.P$1, U6.28 (PA19/I3/SERCOM1+3.3/I2SD0)
MOSI: SD1.3 (DATA_IN), TP13.P$1, U6.25 (PA16/I2C/I0/SERCOM1+3.0)
unnamed: R45.1, U10.6 (/INT)
unnamed: R44.1, U9.6 (/INT)
unnamed: R48.2, U10.7 (A0)
unnamed: R51.2, U10.8 (A1)
unnamed: R46.2, U9.7 (A0)
unnamed: R49.2, U9.8 (A1)
unnamed: R18.1, RESET.A, RESET.A' (P1)
unnamed: R35.2, U7.3 (EN)
unnamed: JP1.1, R11.1, R12.1
unnamed: C6.1, U6.2 (PA01/EINT1/SERCOM1.1), X2.P$1
unnamed: C8.1, U6.1 (PA00/EINT0/SERCOM1.0), X2.P$2
unnamed: C7.1, U6.4 (PA03/EINT3/VREFA/AIN1)
unnamed: C27.1, U6.43 (VDDCORE)
unnamed: LED1.A, R20.1
unnamed: JP1.2, R13.1, R14.1
unnamed: R26.1, R28.2, R29.2
unnamed: R23.1, R24.2, R26.2, U1.3 (FB)
unnamed: C4.1, U1.1 (VINA)
unnamed: L1.1, U1.8 (L1), U1.9 (L1_2)
unnamed: C12.1, C16.1, R23.2, TEC4.2, U1.4 (VOUT), U1.5 (VOUT_2)
unnamed: L1.2, U1.6 (L2), U1.7 (L2_2)
unnamed: R41.1, R42.2, R43.2
unnamed: C20.1, U5.1 (VINA)
unnamed: R30.1, U3.2 (RT)
unnamed: R39.1, R40.2, R41.2, U5.3 (FB)
unnamed: C28.1, C31.1, R39.2, TEC3.2, U5.4 (VOUT), U5.5 (VOUT_2)
unnamed: L2.1, U5.8 (L1), U5.9 (L1_2)
unnamed: L2.2, U5.6 (L2), U5.7 (L2_2)
unnamed: R25.1, U4.5 (RDY/*BSY)
unnamed: R54.1, R56.2, R58.2
unnamed: C37.1, U8.1 (VINA)
unnamed: R52.1, R53.2, R54.2, U8.3 (FB)
unnamed: C42.1, C43.1, R52.2, TEC2.2, U8.4 (VOUT), U8.5 (VOUT_2)
unnamed: L4.1, U8.8 (L1), U8.9 (L1_2)
unnamed: L4.2, U8.6 (L2), U8.7 (L2_2)
unnamed: Q6.1 (S), Q6.2 (S), Q6.3 (S), R34.2, U3.5 (ISEN)
unnamed: R75.1, R76.2, R77.2
unnamed: C23.1, R33.2, U3.1 (ADJ)
unnamed: C24.1, C25.1, R32.1
unnamed: C24.2, R37.2, R38.1, U3.3 (FB)
unnamed: C46.1, U11.1 (VINA)
unnamed: R73.1, R74.2, R75.2, U11.3 (FB)
unnamed: C22.2, U3.7 (VCC)
unnamed: C47.1, C48.1, R73.2, TEC1.2, U11.4 (VOUT), U11.5 (VOUT_2)
unnamed: L5.1, U11.8 (L1), U11.9 (L1_2)
unnamed: L5.2, U11.6 (L2), U11.7 (L2_2)
unnamed: D2.2 (C), L3.1, Q6.5 (D), Q6.6 (D), Q6.7 (D), Q6.8 (D), Q6.9 (D), R32.2
unnamed: Q6.4 (G), U3.6 (PGATE)
unnamed: R82.1, U12.4 (ILIM)
unnamed: R80.2, U12.2 (IN2)
unnamed: R81.2, U12.3 (IN1)
unnamed: C50.1, C51.+, SJ1.2, U12.5 (VM)
OUT1: TEC5.2, U12.6 (OUT1)
OUT2: TEC5.1, U12.8 (OUT2)
PWM_0: R28.1, R80.1, U6.7 (PB08/I8/AIN2/SERCOM4.0)
PWM_1: R43.1, R81.1, U6.8 (PB09/I9/AIN3/SERCOM4.1)
PWM_2: R56.1, U6.19 (PB10/I10/SERCOM4.2/I2SMC)
PWM_3: R76.1, U6.20 (PB11/I11/SERCOM4.3/I2SCL)
SCK: SD1.5 (SCLK), TP15.P$1, U6.26 (PA17/I2C/I1/SERCOM1+3.1)
SCL_1: R47.1, TP8.P$1, U6.32 (PA23/I2C/I7/SERCOM3+5.1/SOF), U9.3 (SCL), U10.3 (SCL)
SCL_2: Q3.2, R8.1, R13.2, TP10.P$1, U6.22 (PA13/I13/I2C/SERCOM2+4.1)
SCL_2_H: Q3.3, R14.2, R19.1
SCL_3: Q2.2, R7.1, TP12.P$1, U6.14 (PA09/I2C/I9/AIN17/SERCOM0+2.1/I2SMC)
SCL_3_H: Q2.3, R16.1, U4.2 (SCL)
SDA_1: R50.1, TP7.P$1, U6.31 (PA22/I2C/I6/SERCOM3+5.0), U9.2 (SDA), U10.2 (SDA)
SDA_2: Q5.2, R6.1, R11.2, TP9.P$1, U6.21 (PA12/I12/I2C/SERCOM2+4.0)
SDA_2_H: Q5.3, R12.2, R15.1
SDA_3: Q4.2, R4.1, TP11.P$1, U6.13 (PA08/I2C/AIN16/SERCOM0+2.0/I2SD1)
SDA_3_H: Q4.3, R10.1, U4.3 (SDA)
SERIAL_NUM_1W: CHIP0.5, CHIP1.5, CHIP2.5, CHIP3.5, CHIP4.5, CHIP5.5, CHIP6.5, CHIP7.5, R21.1, U6.29 (PA20/I4/SERCOM3+5.2/I2SSC)
SWCLK: DEBUG.4 (SWDCLK/TCK), R22.1, TP18.P$1, U6.45 (PA30/I10/SECOM1.2/SWCLK)
SWDIO: DEBUG.2 (SWDIO/TMS), TP17.P$1, U6.46 (PA31/I11/SECOM1.3/SWDIO)
TEC_EN: Q1.1 (G), U6.10 (PA05/EINT5/AIN5/SERCOM0.1)
USBD_N: U6.33 (PA24/I12/SERCOM3+5.2/D-), USB.D-
USBD_P: U6.34 (PA25/I13/SERCOM3+5.3/D+), USB.D+
VCC: C1.1, JP1.3, R1.2, R3.2
VDAC_0: R29.1, U4.6 (VOUTA)
VDAC_1: R42.1, U4.7 (VOUTB)
VDAC_2: R58.1, U4.8 (VOUTC)
VDAC_3: R77.1, U4.9 (VOUTD)
VREG_IN: C9.1, C13.1, D1.C, R35.1, U2.3 (IN), U7.1 (IN)

Notes on the sheet:
EASY CHECK MAIN BOARD REV1 2019/04/26
CHIP CONNECTOR
DISPLAY
EXTERNAL INTERFACES
HEATER CONTROL DIGITAL
AMBIENT TEMPERATURE SENSORS
RESISTANCE MEASUREMENT
POWER
SERIAL NUMBER IC: DS2411: 1Wire comm; pullup on chip
CHIP TEMPERATURE MEASURMENT
If the 2.56-V internal VREF is used, leave VREF pin unconnected. Datasheet recommends using an external ref. Is it really necessary?
A0: LOW A1: LOW Serial bus Address (hex): 1D
A0: LOW A1: HIGH Serial bus Address (hex): 35
MICROCONTROLLER
I2C 128X64 LCD display @3.3V: MOSFETS: DNP R35,R41,R43: 0R R36, R39, R40, R42, R44: DNP @5V: MOSFETS: DMN6140L R35,R41,R43: DNP R36, R39, R40, R42, R44: 0R
TESTPOINTS
MEMORY (Micro SD Card)
Reference: http://www.ti.com/lit/an/slva677/slva677.pdf
TEC1-12703
TEC Datasheet: http://www.thermonamic.com/TEC1-12703-English.pdf
Max current provided by buck boost: 2A TEC Voltage between 3.3V and 5V <> controlled at ~ 1A.
HEATER CONTROL MOTOR DRIVER
SPZ1HM470E08000RAXXX

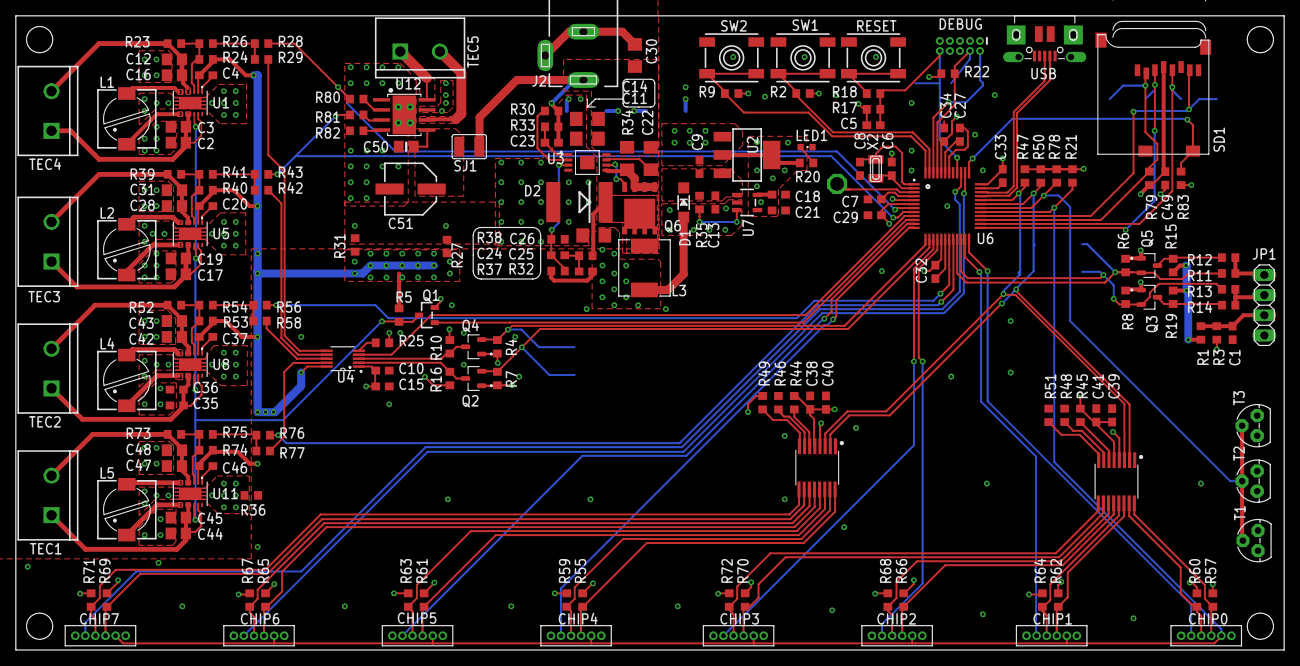
[picture p13: board EasyCheck_rev1.brd from above]

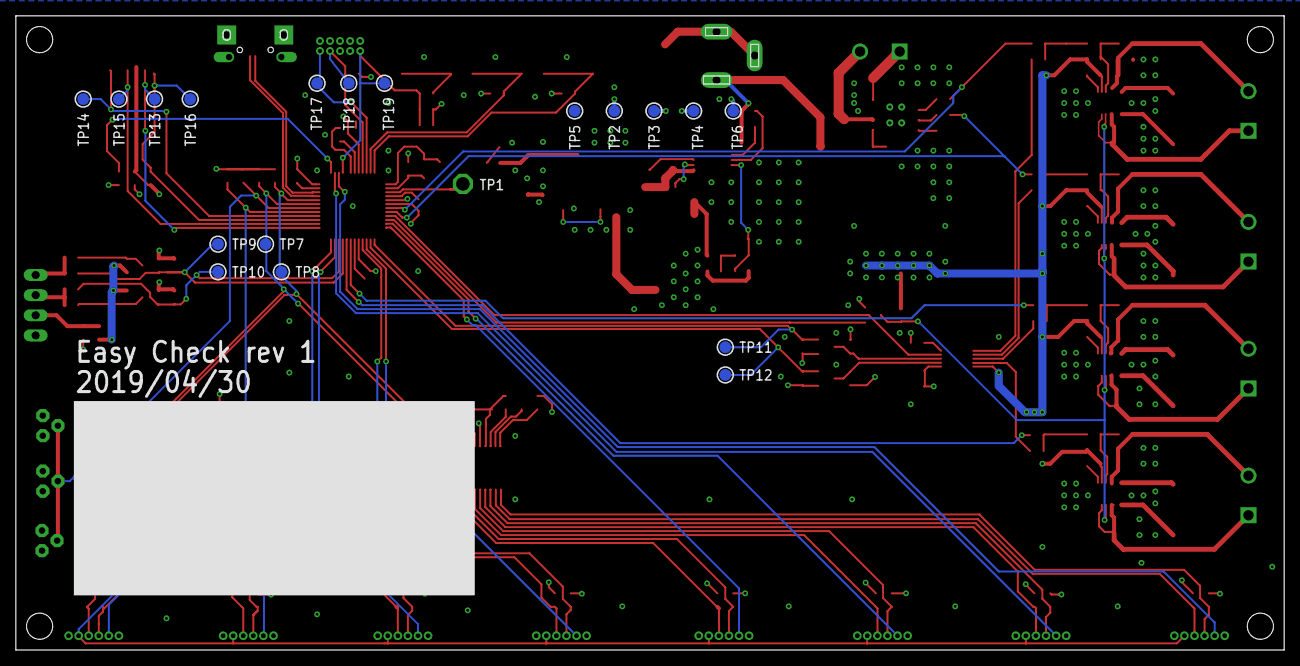
[picture p14: board EasyCheck_rev1.brd from below]

Board: 4 copper layers, 160.0 x 80.0 mm, 205 parts (19 on the bottom side), 121 nets.
