rayan4444/EasyCheck/EasyCheck_rev1/EasyCheck_CHIP_REV1.brd

## EAGLE design EasyCheck_rev1/EasyCheck_CHIP_REV1.brd (2019-05-28, an earlier design)

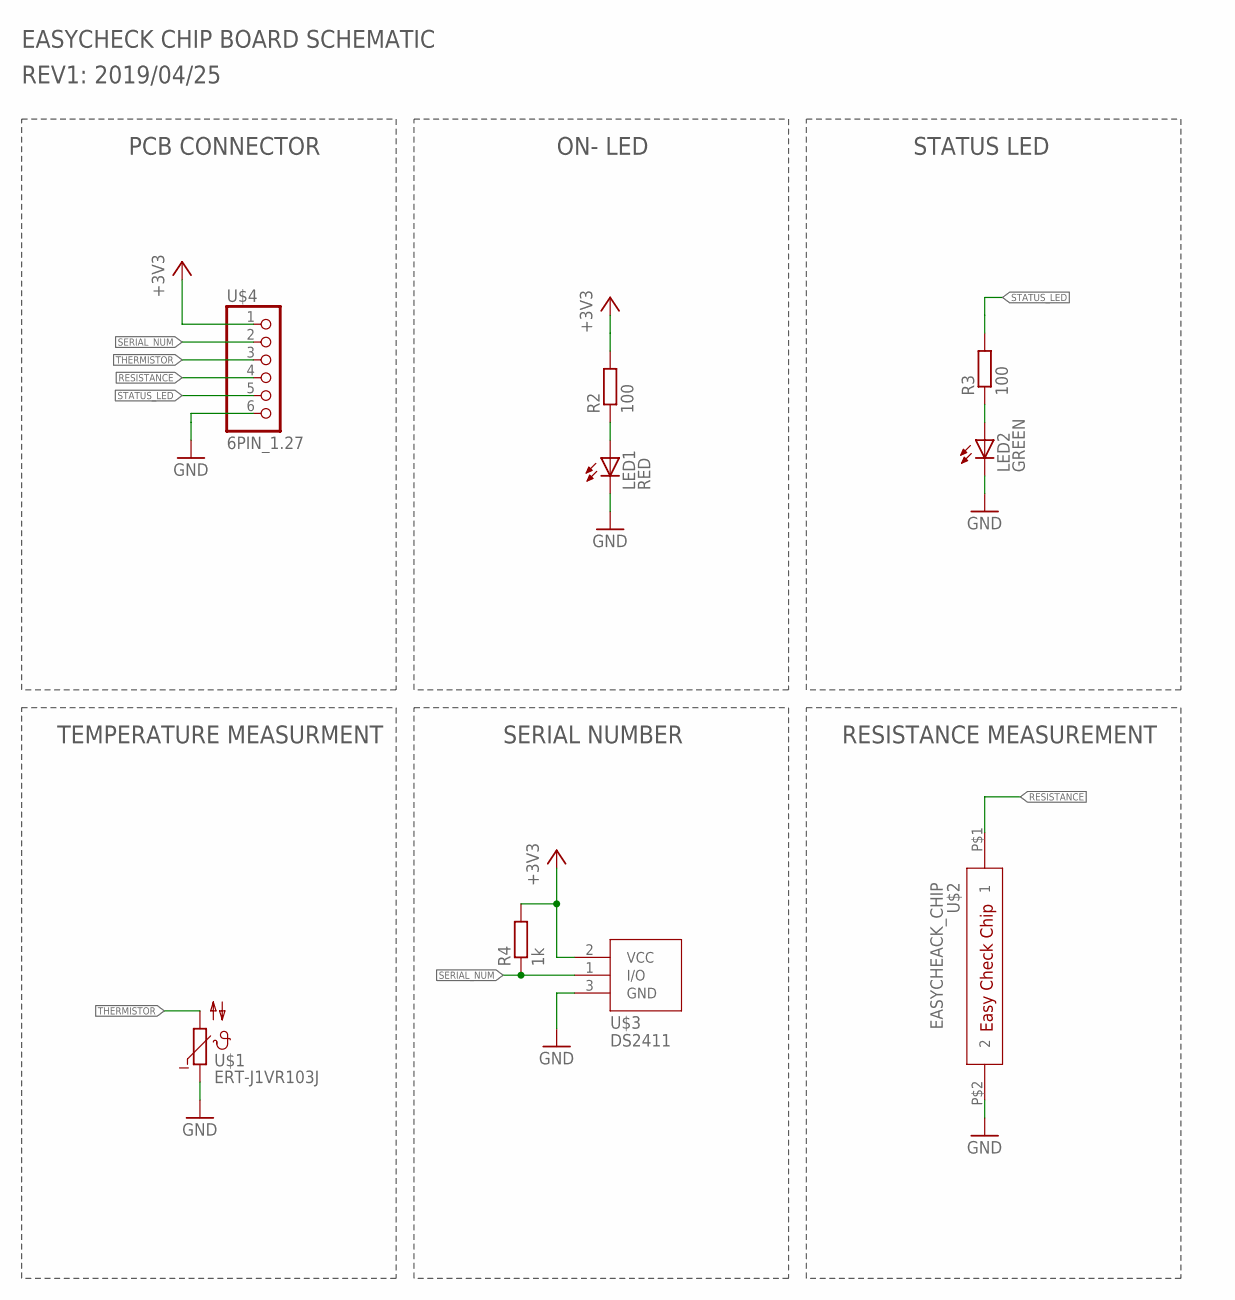
[picture p15: schematic EasyCheck_CHIP_REV1.sch]

Parts:
LED1: RED; CHIPLED_0603
LED2: GREEN; CHIPLED_0603
R2, R3: 100; R0402
R4: 1k; R0402
U$1: ERT-J1VR103J; C0603K
U$2: EASYCHEACK_CHIP; EASYCHECK_CHIP
U$3: DS2411; SOT23
U$4: 6PIN_1.27; 6X1PIN_1.27

Connections:
+3V3: R2.2, R4.2, U$3.2 (VCC), U$4.1
GND: LED1.C, LED2.C, U$1.1, U$2.P$2 (2), U$3.3 (GND), U$4.6
unnamed: LED1.A, R2.1
unnamed: LED2.A, R3.1
RESISTANCE: U$2.P$1 (1), U$4.4
SERIAL_NUM: R4.1, U$3.1 (I/O), U$4.2
STATUS_LED: R3.2, U$4.5
THERMISTOR: U$1.2, U$4.3

Notes on the sheet:
EASYCHECK CHIP BOARD SCHEMATIC
REV1: 2019/04/25
PCB CONNECTOR
TEMPERATURE MEASURMENT
ON- LED
STATUS LED
RESISTANCE MEASUREMENT
SERIAL NUMBER

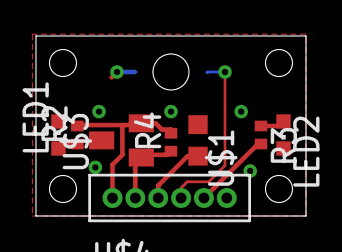
[picture p16: board EasyCheck_CHIP_REV1.brd from above]

Board: 2 copper layers, 15.0 x 10.0 mm, 9 parts (1 on the bottom side), 8 nets.
