rayan4444/EasyCheck/(commit log)

2019-05-28 Added hardware files, libraries and Test code for Rev1, updated errata in readme
    [EasyCheck_CHIP_REV1.brd, EasyCheck_CHIP_REV1.sch, EasyCheck_rev1.brd, EasyCheck_rev1.sch]
2019-05-31 added BOM
    [EasyCheck_rev1_BOM.csv]
2019-06-18 Added rev2 hardware files
    [EasyCheck_rev2_interface.brd, EasyCheck_rev2_interface.sch, Easy_Check_rev2_chip_tray.brd, Easy_Check_rev2_chip_tray.sch, Easycheck_rev2_chip.brd, Easycheck_rev2_chip.sch, Easycheck_rev2_motherboard.brd, Easycheck_rev2_motherboard.sch]
2019-06-18 Added rev 2 BOM
    [Easy_Check_rev2_BOM.csv]
2019-07-05 Bug free code so far
    Main working code, everything working separately tested, full test routine not working yet. + README with errata
    [EasyCheck_rev2.ino]
2019-07-06 full functioning code
    nice to have:
    - modify PID loop to achieve faster results
    - scale plot x axis to duration
    - better alignment of graphics
2019-07-09 Added modified board definition files
2019-07-09 Corrected hardware files
    [EasyCheck_rev2_interface.brd, EasyCheck_rev2_interface.sch, Easycheck_rev2_motherboard.brd, Easycheck_rev2_motherboard.sch]
